happymonk-ai/enclosures/Project/Battery Pack and Draft files/Battery pack 2U Full Rack Enclosure/img-3.JPG

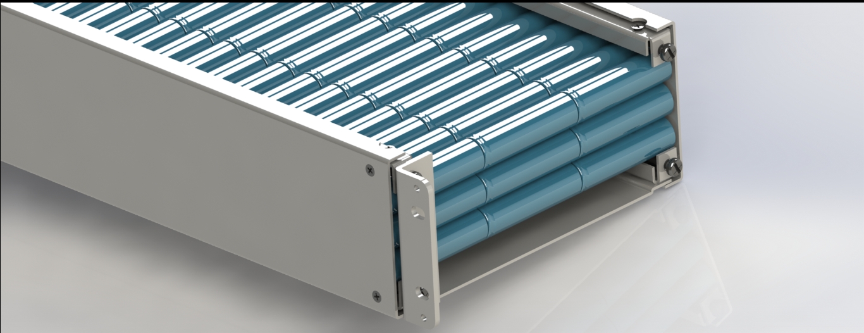
Project/Battery Pack and Draft files/Battery pack 2U Full Rack Enclosure/img-3.JPG
