happymonk-ai/enclosures/Project/New Main Module Enclosure/ethernet-switch-1.snapshot.3/Mercusys_MS105G.JPG

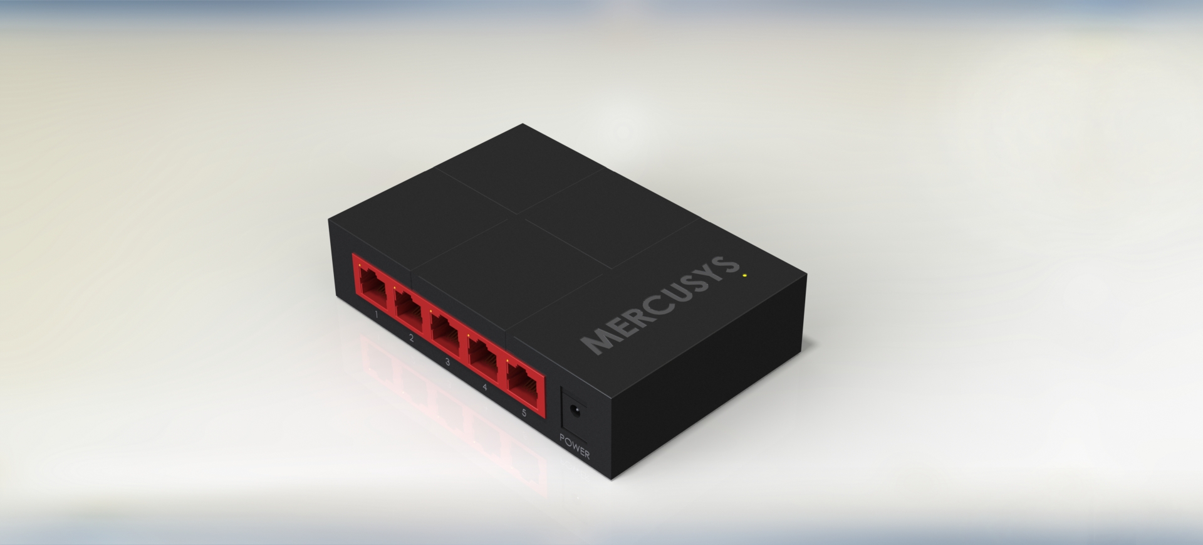
Project/New Main Module Enclosure/ethernet-switch-1.snapshot.3/Mercusys_MS105G.JPG
