happymonk-ai/enclosures/Project/Battery Pack and Draft files/Battery pack 1U Full Rack Enclosure/Batteries Placed horizontally in 1u .jpg

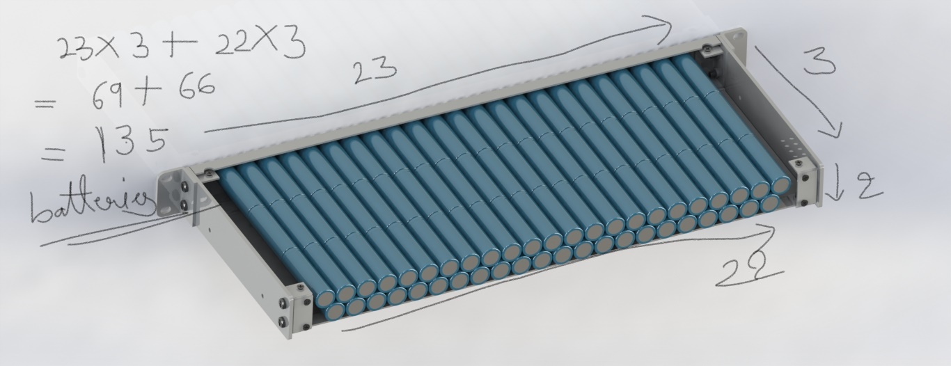
Project/Battery Pack and Draft files/Battery pack 1U Full Rack Enclosure/Batteries Placed horizontally in 1u .jpg
