happymonk-ai/enclosures/Project/Battery Pack and Draft files/Battery pack 1U Full Rack Enclosure/Battery placed perfectly.JPG

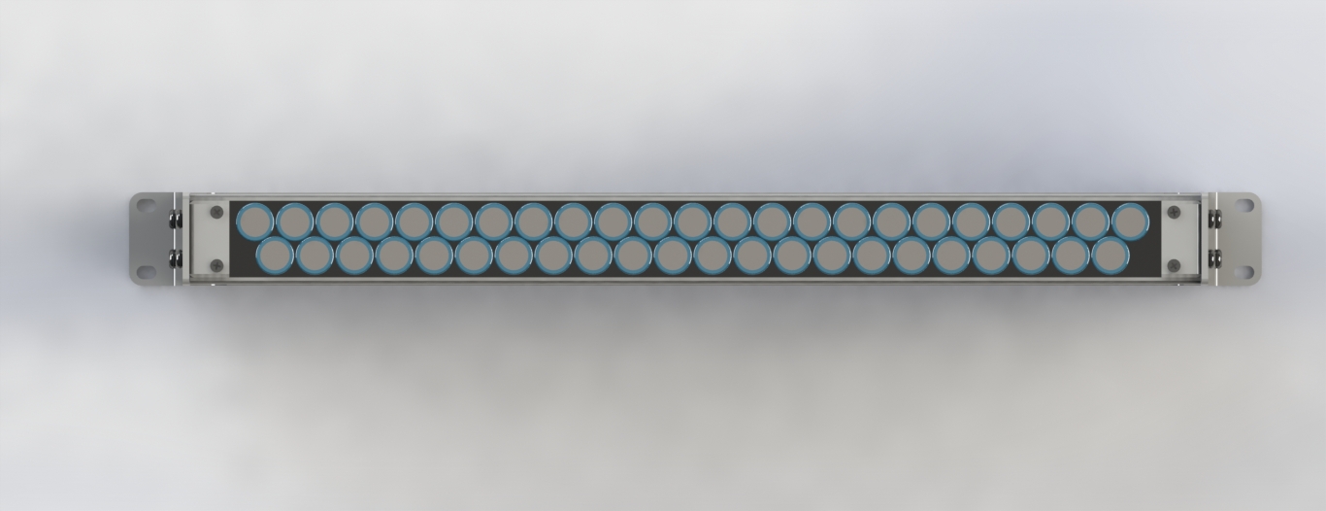
Project/Battery Pack and Draft files/Battery pack 1U Full Rack Enclosure/Battery placed perfectly.JPG
