happymonk-ai/enclosures/Project/Battery Pack and Draft files/Battery pack 1U Full Rack Enclosure/img - 1.JPG

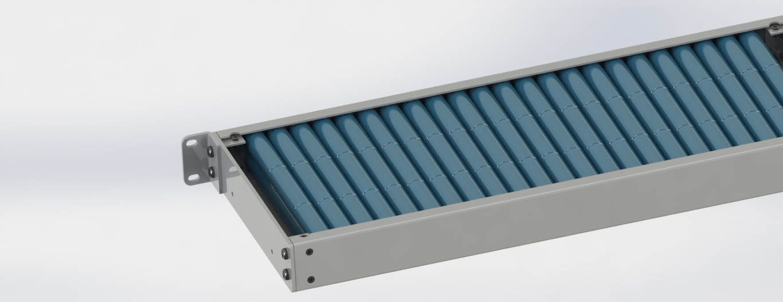
Project/Battery Pack and Draft files/Battery pack 1U Full Rack Enclosure/img - 1.JPG
