happymonk-ai/enclosures/Project/Battery Pack and Draft files/Battery pack 2U Full Rack Enclosure/batteries place vertically.JPG

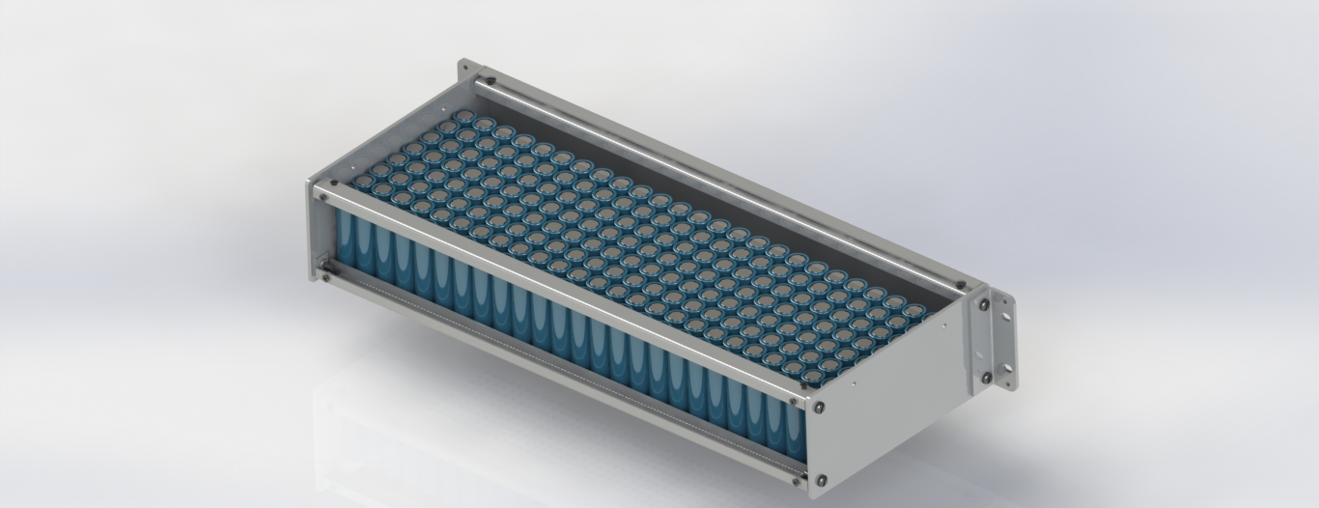
Project/Battery Pack and Draft files/Battery pack 2U Full Rack Enclosure/batteries place vertically.JPG
