happymonk-ai/enclosures/Project/Battery Pack and Draft files/Battery pack 2U Full Rack Enclosure/Batteries placed horizontal to the front plate.jpg

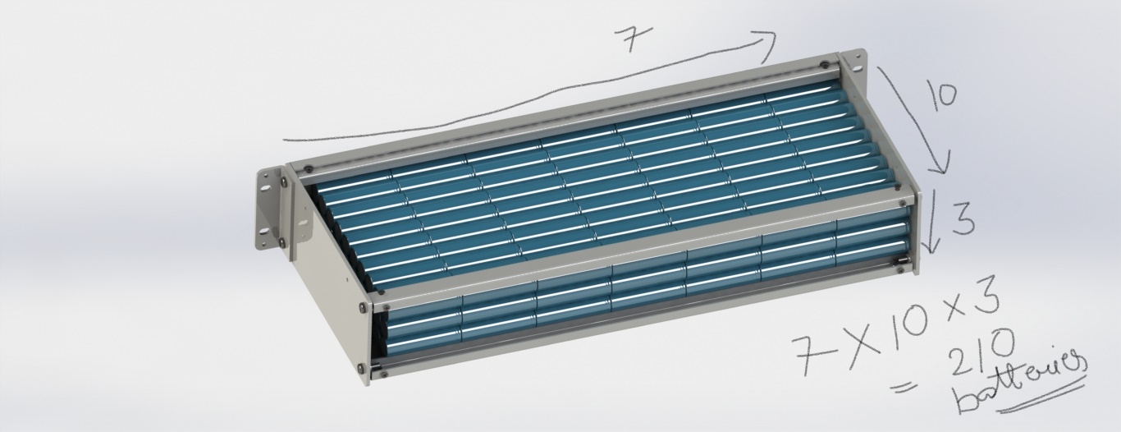
Project/Battery Pack and Draft files/Battery pack 2U Full Rack Enclosure/Batteries placed horizontal to the front plate.jpg
