happymonk-ai/enclosures/Project/Full Rack/8-port-rj45-socket-1.snapshot.2/RJ45 x 8.jpg

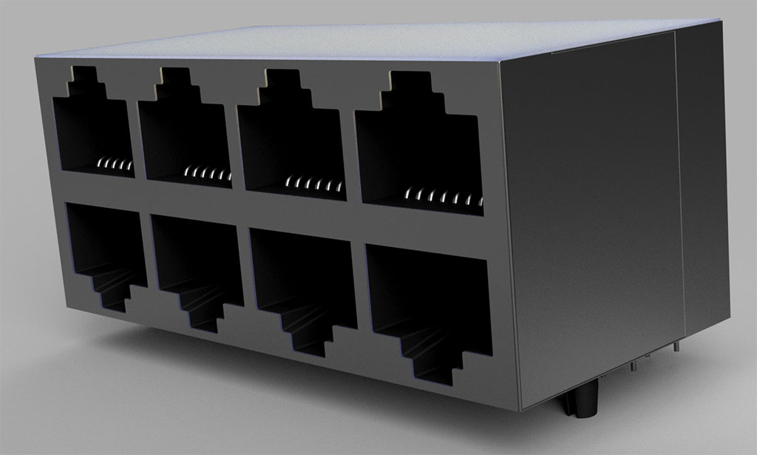
Project/Full Rack/8-port-rj45-socket-1.snapshot.2/RJ45 x 8.jpg
