happymonk-ai/enclosures/Project/New Main Module Enclosure/Ethernet cable - 1/909.png

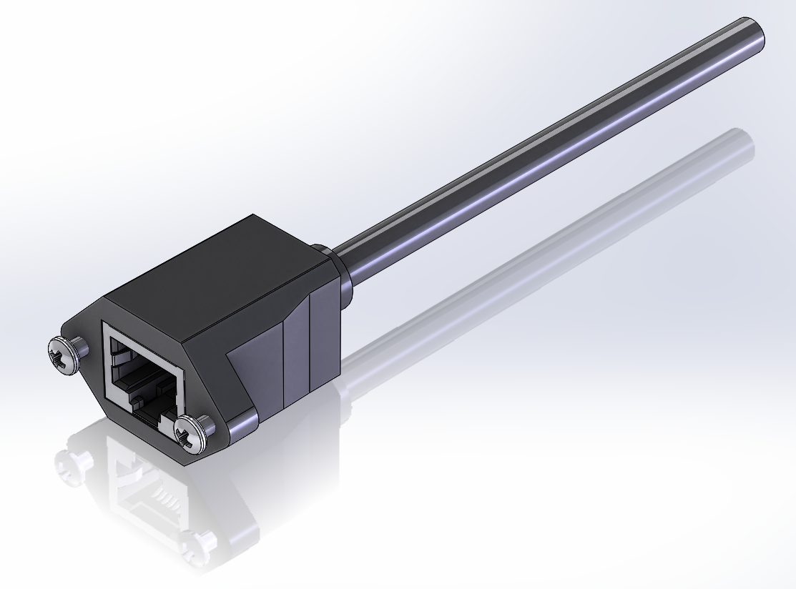
Project/New Main Module Enclosure/Ethernet cable - 1/909.png
