happymonk-ai/enclosures/Project/New Main Module Enclosure/Ethernet RJ45/img.JPG

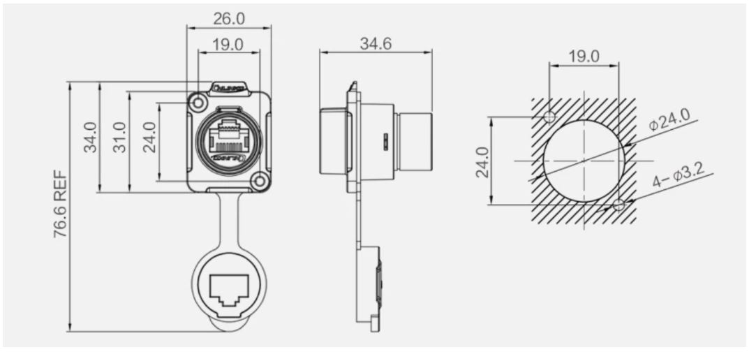
Project/New Main Module Enclosure/Ethernet RJ45/img.JPG
