happymonk-ai/enclosures/Project/New Main Module Enclosure/iec-screw-mount-plug-socket-male-1.snapshot.1/IEC Screw Mount Plug Socket Male/IEC Screw Mount Plug Socket Male-04.JPG

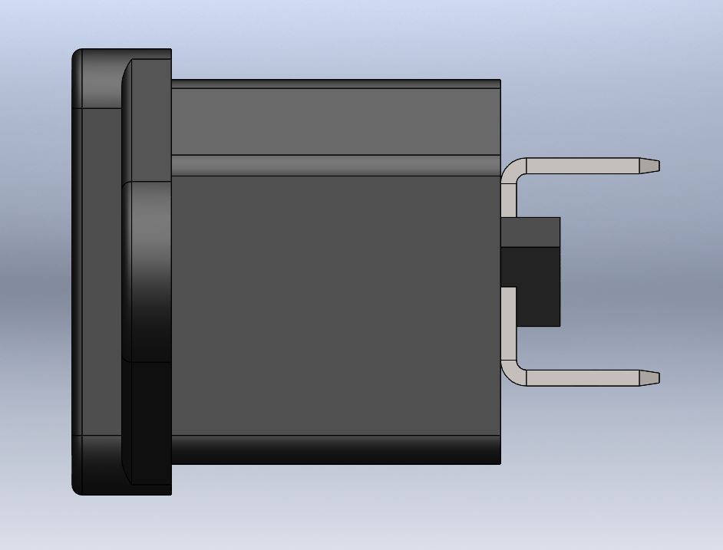
Project/New Main Module Enclosure/iec-screw-mount-plug-socket-male-1.snapshot.1/IEC Screw Mount Plug Socket Male/IEC Screw Mount Plug Socket Male-04.JPG
