happymonk-ai/enclosures/Project/New Main Module Enclosure/led-5mm-red-through-hole-1.snapshot.10/LED_5mm_red.png

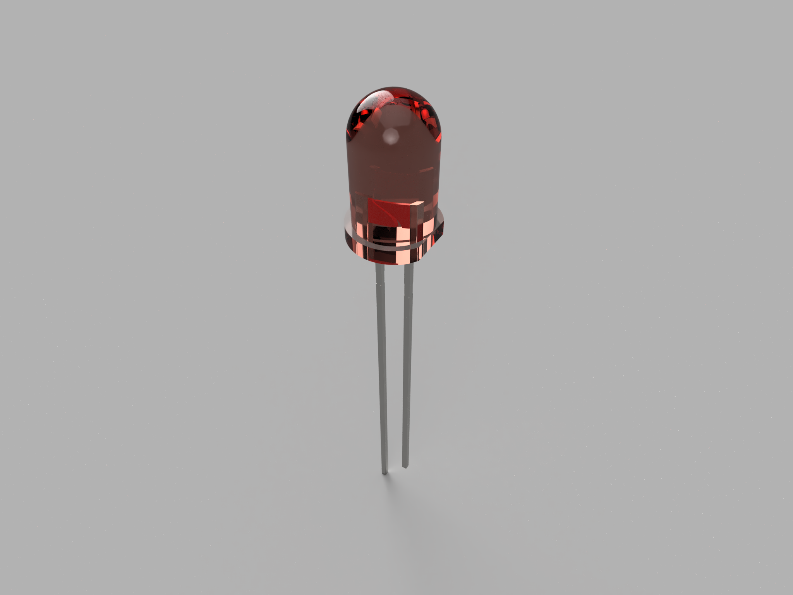
Project/New Main Module Enclosure/led-5mm-red-through-hole-1.snapshot.10/LED_5mm_red.png
