happymonk-ai/enclosures/Project/New Main Module Enclosure/power-connector-iec-c4-3-pins-1.snapshot.2/IEC-C4-3pins.JPG

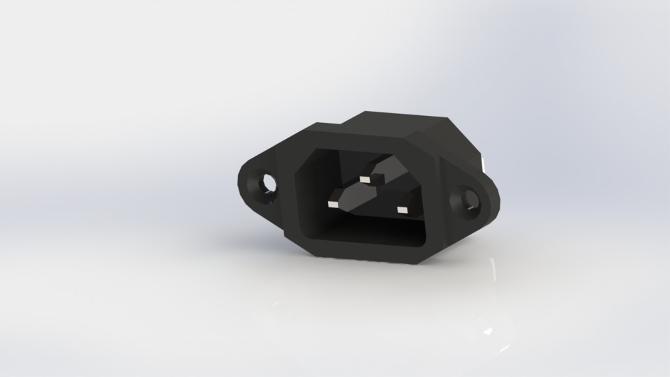
Project/New Main Module Enclosure/power-connector-iec-c4-3-pins-1.snapshot.2/IEC-C4-3pins.JPG
