happymonk-ai/enclosures/Project/New Main Module Enclosure/power-supply-24vdc-10a-1.snapshot.2/Power Supply 24VDC 10A v1.png

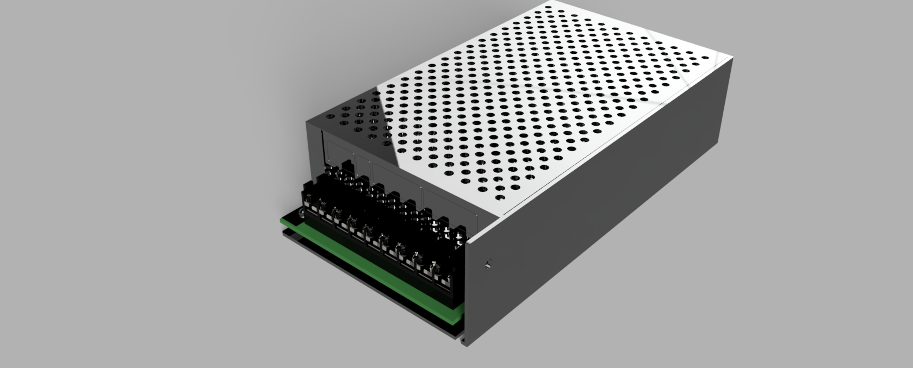
Project/New Main Module Enclosure/power-supply-24vdc-10a-1.snapshot.2/Power Supply 24VDC 10A v1.png
