happymonk-ai/enclosures/Project/New Main Module Enclosure/raspberry-pi-4-port-usb-hub-hat-1.snapshot.3/71MjlTHb0gL._SL1113_.jpg

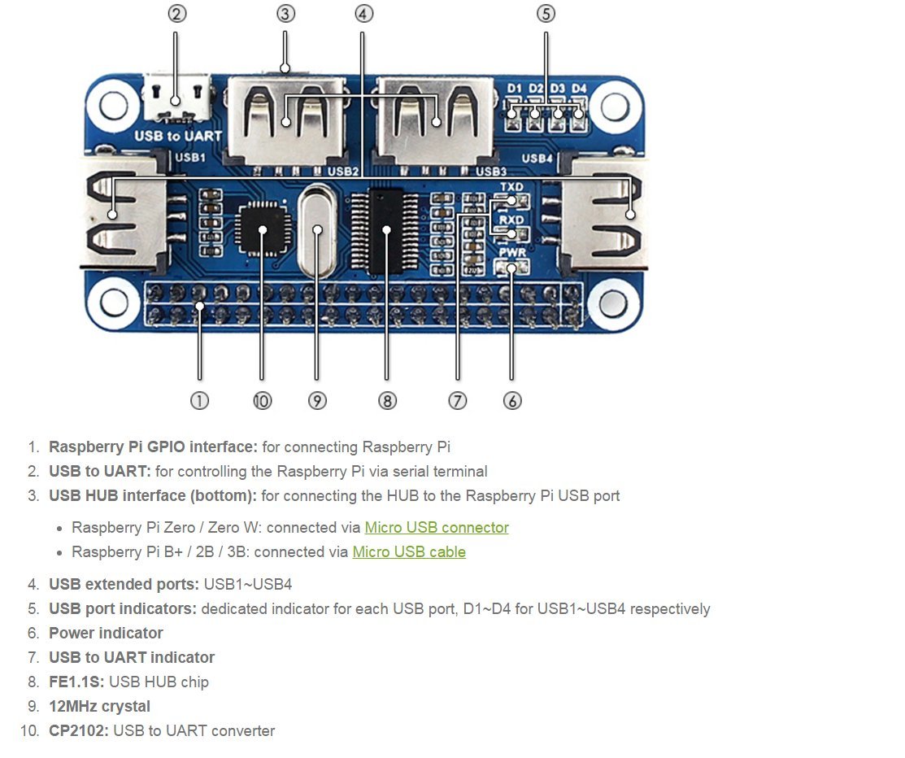
Project/New Main Module Enclosure/raspberry-pi-4-port-usb-hub-hat-1.snapshot.3/71MjlTHb0gL._SL1113_.jpg
