happymonk-ai/enclosures/Project/New Main Module Enclosure/raspberry-pi-4-port-usb-hub-hat-1.snapshot.3/PCB 65x30x1.6.jpg

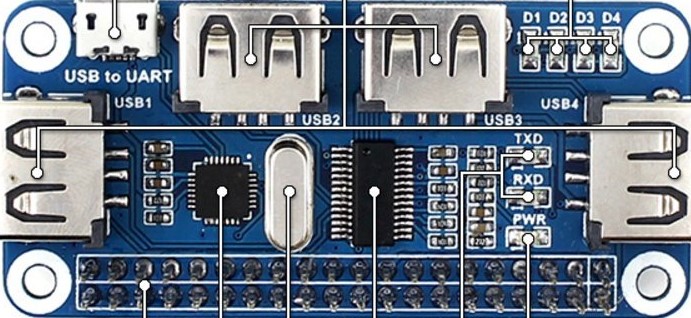
Project/New Main Module Enclosure/raspberry-pi-4-port-usb-hub-hat-1.snapshot.3/PCB 65x30x1.6.jpg
