happymonk-ai/enclosures/Project/New Main Module Enclosure/raspberry-pi-4-port-usb-hub-hat-1.snapshot.3/Raspberry pi 4 Port USB HUB HAT - 1.JPG

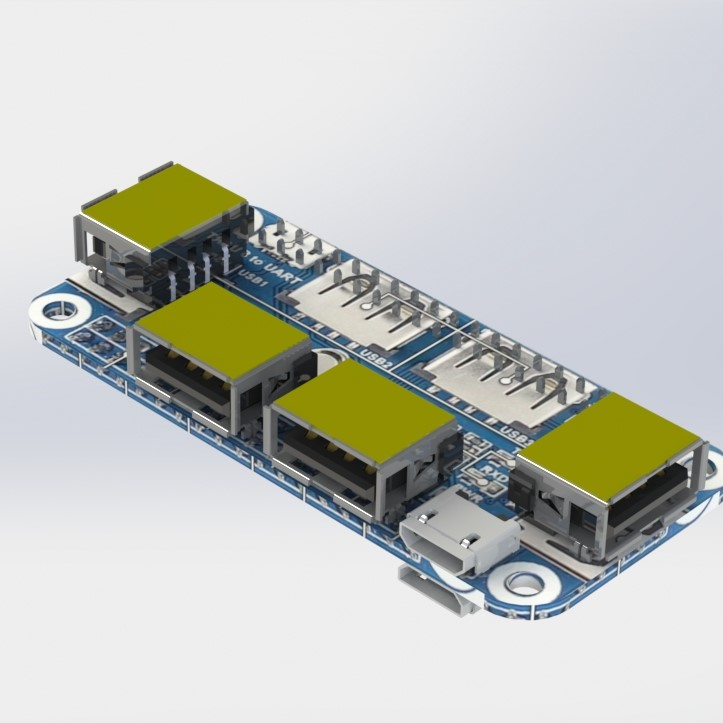
Project/New Main Module Enclosure/raspberry-pi-4-port-usb-hub-hat-1.snapshot.3/Raspberry pi 4 Port USB HUB HAT - 1.JPG
