happymonk-ai/enclosures/Project/New Main Module Enclosure/USB RJ45/img - 1.JPG

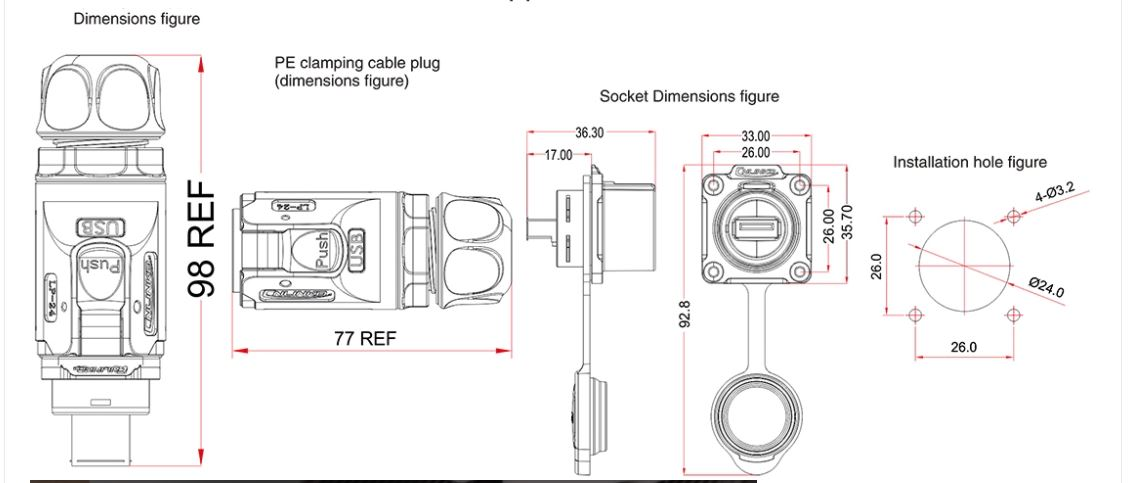
Project/New Main Module Enclosure/USB RJ45/img - 1.JPG
