happymonk-ai/enclosures/Project/Battery Pack and Draft files/Project/Full rack 2U Enclosure Project.SLDASM

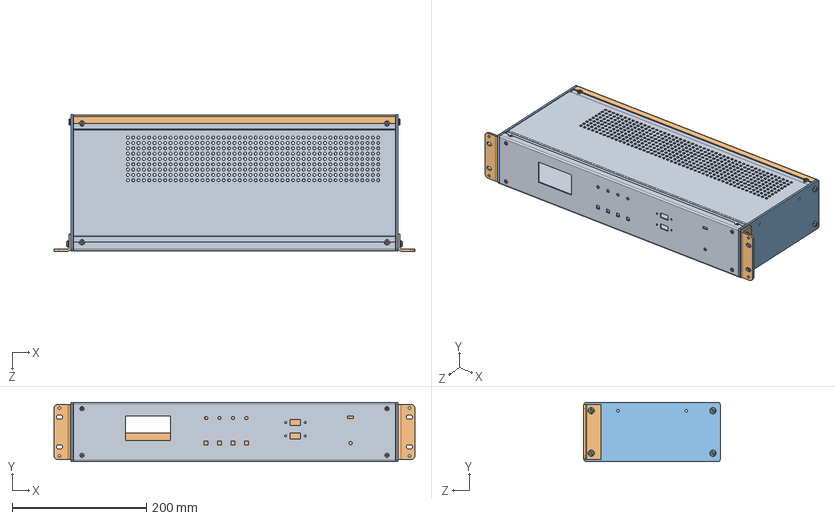
[picture p31: CAD file, 2021-10-08]
Project/Battery Pack and Draft files/Project/Full rack 2U Enclosure Project.SLDASM
537.9 x 88.4 x 203.4 mm
COM53877-2 x 2
COM53880 x 2
COM53875-2 x 2
SCS19498 x 8
SCS19535 x 16
NTS16752 x 16
COM53874-2 x 4
NTS16847 x 8
Front Plate - 1
Front plate - 2
