happymonk-ai/enclosures/Project/Half Rack/Antenna/NRF24L01L + Antenna 2.4 GHz/Antenna assy.SLDASM

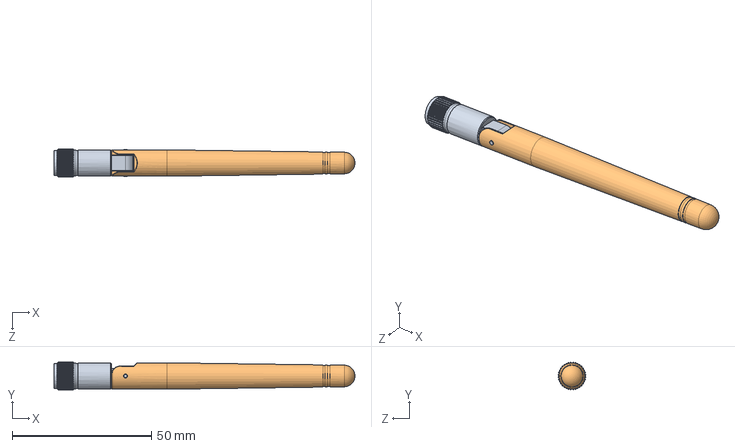
[picture p32: CAD file, 2021-09-29]
Project/Half Rack/Antenna/NRF24L01L + Antenna 2.4 GHz/Antenna assy.SLDASM
108.2 x 9.98 x 9.98 mm
Antenna base
Antenna top
