happymonk-ai/enclosures/Project/New Main Module Enclosure/Box for Main Module.SLDPRT

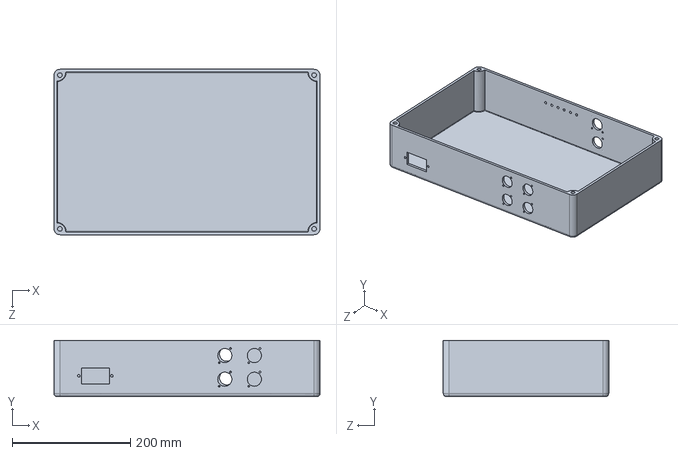
[picture p33: CAD file, 2021-11-02]
Project/New Main Module Enclosure/Box for Main Module.SLDPRT
450.0 x 95.0 x 280.0 mm
