happymonk-ai/enclosures/Project/New Main Module Enclosure/HDMI RJ45/Connector.sldasm

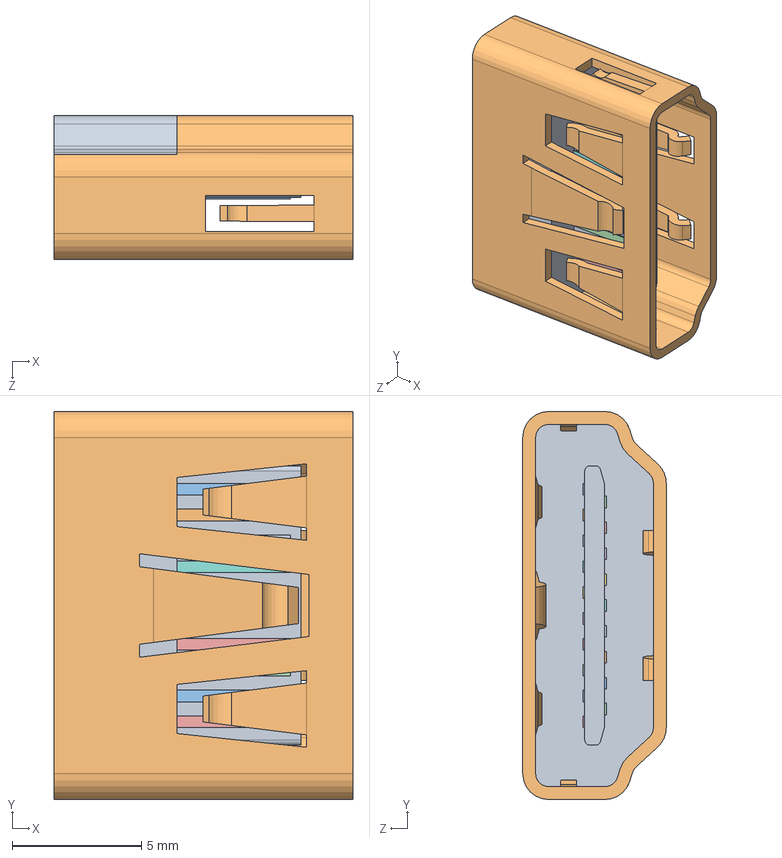
[picture p34: CAD file, 2021-11-02]
Project/New Main Module Enclosure/HDMI RJ45/Connector.sldasm
11.6 x 15.0 x 5.55 mm
Mold
Pins_18
Pins_10
Pins_7
Pins_12
Pins_3
Pins_19
Pins_4
Pins_17
Pins_5
Pins_2
Pins_16
Pins_11
Pins_6
Pins_14
Pins_9
Pins_13
Pins
Pins_8
Pins_15
