happymonk-ai/enclosures/Project/New Main Module Enclosure/led-5mm-red-through-hole-1.snapshot.10/LED, 5mm, green v4.SLDASM

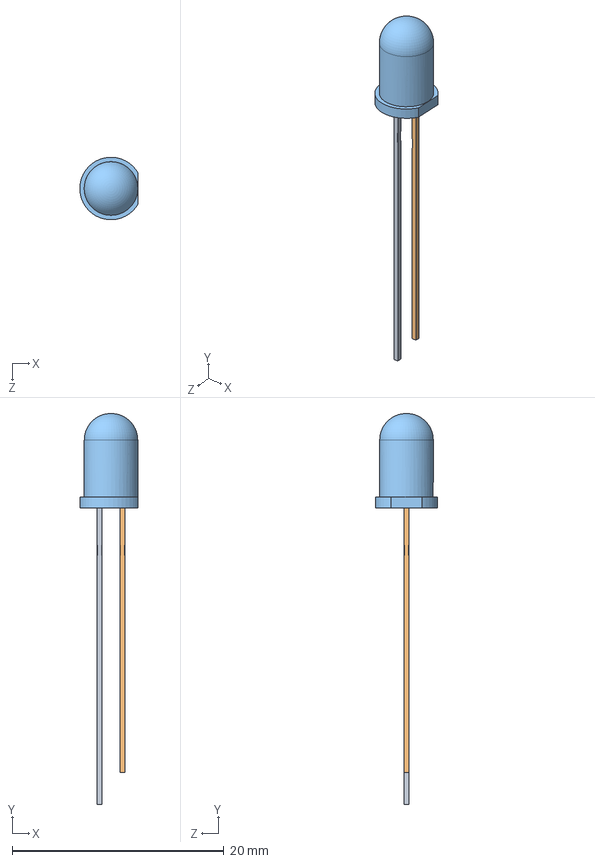
[picture p35: CAD file, 2021-10-27]
Project/New Main Module Enclosure/led-5mm-red-through-hole-1.snapshot.10/LED, 5mm, green v4.SLDASM
5.51 x 36.9 x 5.89 mm
Legs
Legs_2
PlasticHousing
