happymonk-ai/enclosures/Project/Battery Pack and Draft files/Battery pack 2U Full Rack Enclosure/Li ion Battery/li-ion-battery-18650-18500-18350-1.snapshot.2/Lithium ion 3.7V 18650 battery.SLDASM

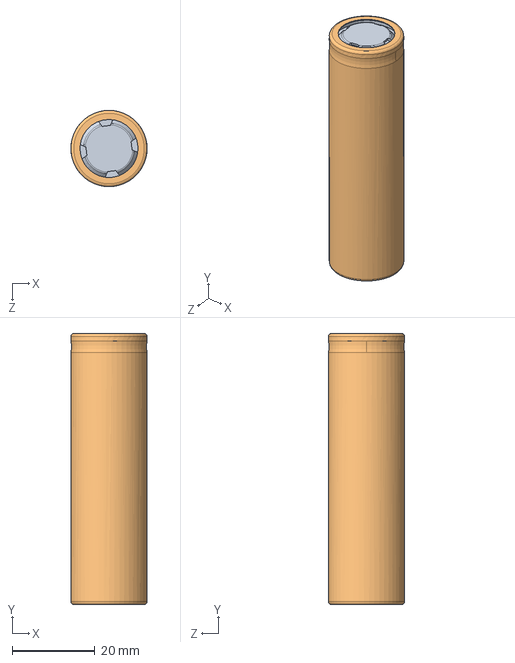
[picture p37: CAD file, 2021-10-08]
Project/Battery Pack and Draft files/Battery pack 2U Full Rack Enclosure/Li ion Battery/li-ion-battery-18650-18500-18350-1.snapshot.2/Lithium ion 3.7V 18650 battery.SLDASM
18.4 x 65.4 x 18.4 mm
18650 Низкий анод_2
18650 Низкий анод
