happymonk-ai/enclosures/Project/Full Rack/2U Full Rack Enclosure/Full Rack Enclosure.SLDASM

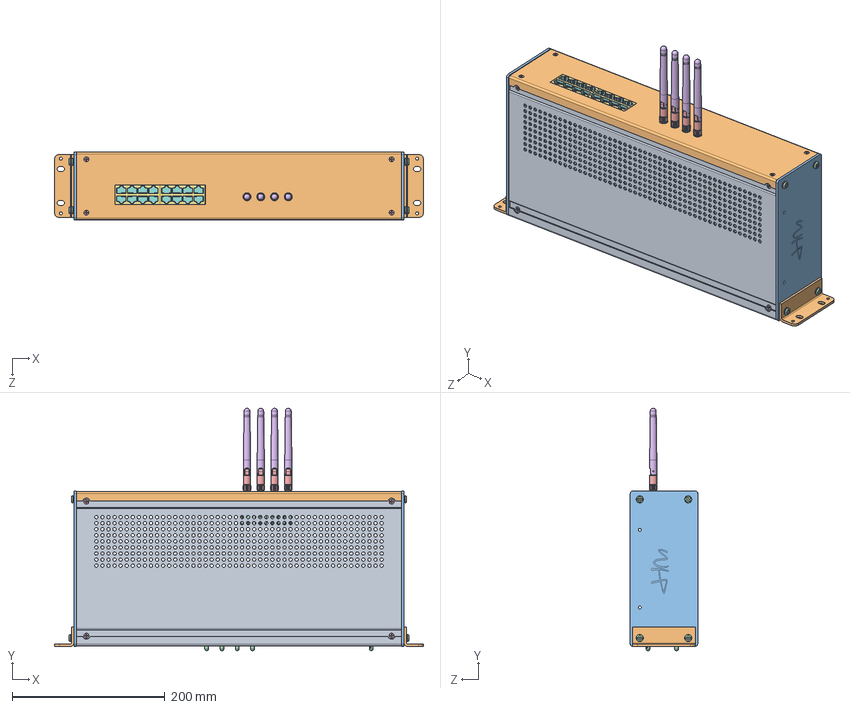
[picture p38: CAD file, 2021-10-08]
Project/Full Rack/2U Full Rack Enclosure/Full Rack Enclosure.SLDASM
482.6 x 317.2 x 88.5 mm
COM53877-2 x 2
COM53880 x 2
COM53875-2 x 2
SCS19498 x 8
SCS19535 x 16
NTS16752 x 16
COM53874-2 x 4
NTS16847 x 8
Front Plate - 1
Front plate - 2
RJ45 x 16_4 x 2
RJ45 x 16_10 x 2
RJ45 x 16_21 x 2
RJ45 x 16_23 x 2
RJ45 x 16_14 x 2
RJ45 x 16_25 x 2
RJ45 x 16_6 x 2
RJ45 x 16_17 x 2
RJ45 x 16_16 x 2
RJ45 x 16_32 x 2
RJ45 x 16_37 x 2
RJ45 x 16_8 x 2
RJ45 x 16_31 x 2
RJ45 x 16_2 x 2
RJ45 x 16_36 x 2
RJ45 x 16_34 x 2
RJ45 x 16_27 x 2
RJ45 x 16_19 x 2
RJ45 x 16_29 x 2
RJ45 x 16_12 x 2
RJ45 x 16_9 x 2
RJ45 x 16_22 x 2
RJ45 x 16_24 x 2
RJ45 x 16_28 x 2
RJ45 x 16_13 x 2
RJ45 x 16_3 x 2
RJ45 x 16_35 x 2
RJ45 x 16_20 x 2
RJ45 x 16_5 x 2
RJ45 x 16_15 x 2
RJ45 x 16 x 2
RJ45 x 16_18 x 2
RJ45 x 16_30 x 2
RJ45 x 16_33 x 2
RJ45 x 16_26 x 2
RJ45 x 16_11 x 2
RJ45 x 16_7 x 2
Socket_69 x 2
Socket_62 x 2
Socket_86 x 2
Socket_52 x 2
Socket_19 x 2
Socket_34 x 2
Socket_8 x 2
Socket_97 x 2
Socket_16 x 2
Socket_25 x 2
Socket_80 x 2
Socket_46 x 2
Socket_43 x 2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
