happymonk-ai/enclosures/Project/New Main Module Enclosure/HDMI RJ45/HDMI Female Connector Assembly.SLDASM

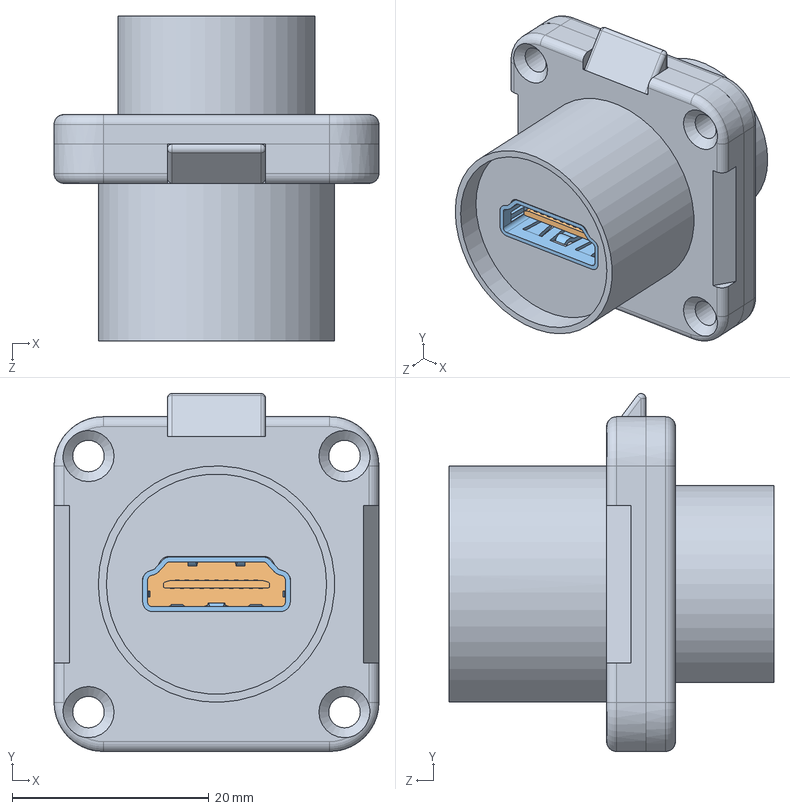
[picture p39: CAD file, 2021-11-02]
Project/New Main Module Enclosure/HDMI RJ45/HDMI Female Connector Assembly.SLDASM
33.0 x 36.4 x 33.0 mm
HDMI Female Female Connector
Mold x 2
Pins_18 x 2
Pins_10 x 2
Pins_7 x 2
Pins_12 x 2
Pins_3 x 2
Pins_19 x 2
Pins_4 x 2
Pins_17 x 2
Pins_5 x 2
Pins_2 x 2
Pins_16 x 2
Pins_11 x 2
Pins_6 x 2
Pins_14 x 2
Pins_9 x 2
Pins_13 x 2
Pins x 2
Pins_8 x 2
Pins_15 x 2
