happymonk-ai/enclosures/Project/New Main Module Enclosure/USB RJ45/USB Assembly.SLDASM

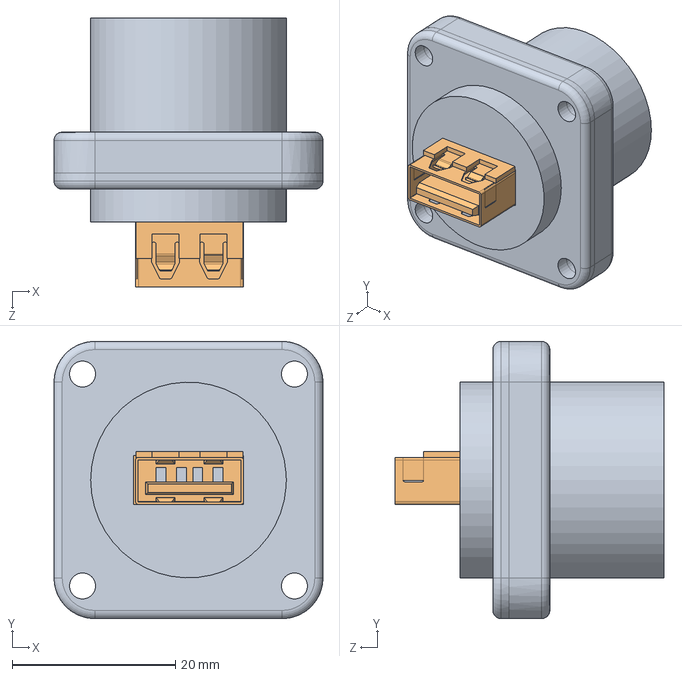
[picture p40: CAD file, 2021-11-02]
Project/New Main Module Enclosure/USB RJ45/USB Assembly.SLDASM
33.0 x 34.0 x 33.0 mm
USB Femal to Female Connector
My USB drive x 2
