happymonk-ai/enclosures/Project/Battery Pack and Draft files/Battery pack 2U Full Rack Enclosure/Battery Pack Enclosure.SLDASM

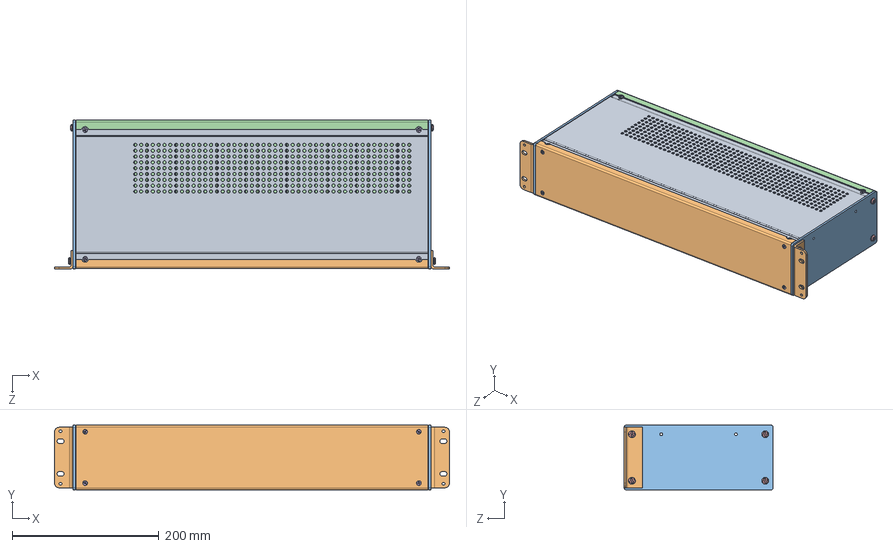
[picture p41: CAD file, 2021-10-13]
Project/Battery Pack and Draft files/Battery pack 2U Full Rack Enclosure/Battery Pack Enclosure.SLDASM
537.9 x 88.4 x 203.4 mm
COM53877-2 x 2
COM53880 x 2
COM53875-2 x 2
SCS19498 x 8
SCS19535 x 16
NTS16752 x 16
COM53874-2 x 4
NTS16847 x 8
front enclose part
18650 Низкий анод_2 x 225
18650 Низкий анод x 225
