happymonk-ai/enclosures/Project/Battery Pack and Draft files/Project/Full rack 2U Enclosure Project - spare.SLDASM

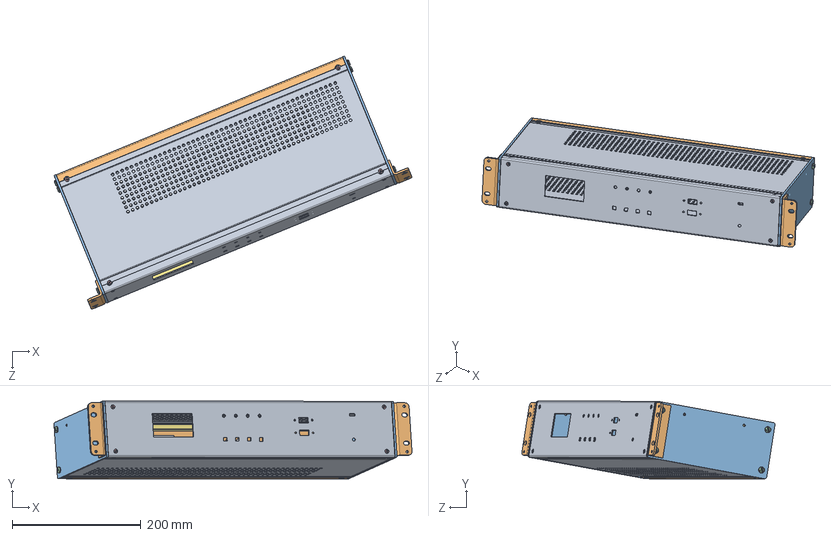
[picture p42: CAD file, 2021-10-08]
Project/Battery Pack and Draft files/Project/Full rack 2U Enclosure Project - spare.SLDASM
555.1 x 120.5 x 392.4 mm
COM53877-2 x 2
COM53880 x 2
COM53875-2 x 2
SCS19498 x 8
SCS19535 x 16
NTS16752 x 16
COM53874-2 x 4
NTS16847 x 8
Front Plate - 1
Front plate - 2
