happymonk-ai/enclosures/Project/Half Rack/Antenna/NRF24L01L + Antenna 2.4 GHz/NRF24L01L+Antenna.SLDASM

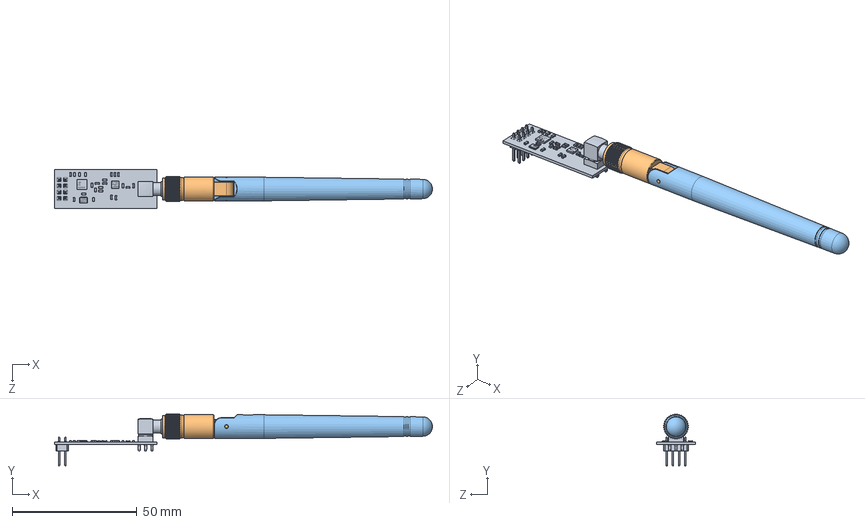
[picture p43: CAD file, 2021-09-29]
Project/Half Rack/Antenna/NRF24L01L + Antenna 2.4 GHz/NRF24L01L+Antenna.SLDASM
151.4 x 20.7 x 15.5 mm
NRF24L01L
Antenna base
Antenna top
