happymonk-ai/enclosures/Project/New Main Module Enclosure/Ethernet RJ45/Ethernet RJ45 Assembly.SLDASM

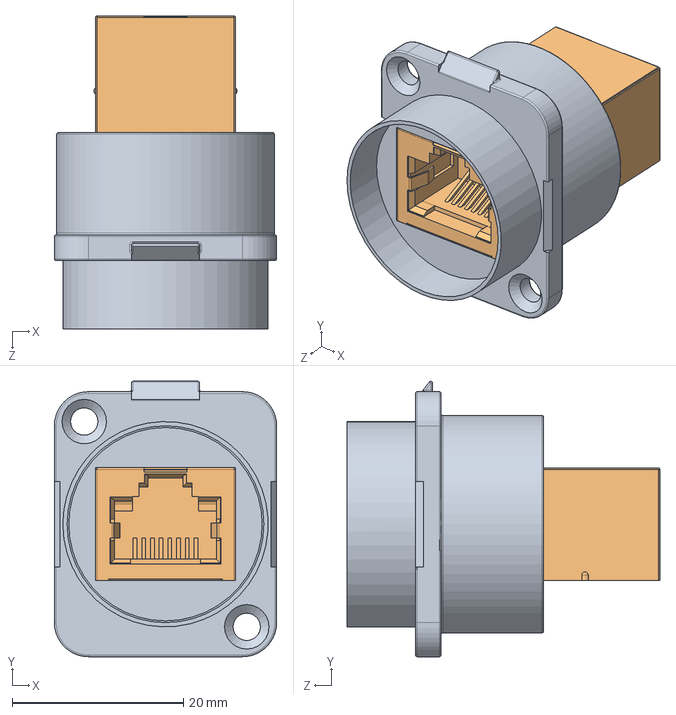
[picture p44: CAD file, 2021-11-02]
Project/New Main Module Enclosure/Ethernet RJ45/Ethernet RJ45 Assembly.SLDASM
26.0 x 32.2 x 36.6 mm
Ethernet Female to Female Input RJ45
Just Ethernet RJ-45 connector x 2
