happymonk-ai/enclosures/Project/New Main Module Enclosure/raspberry-pi-4-port-usb-hub-hat-1.snapshot.3/Raspberry pi 4 Port USB HUB HAT.SLDASM

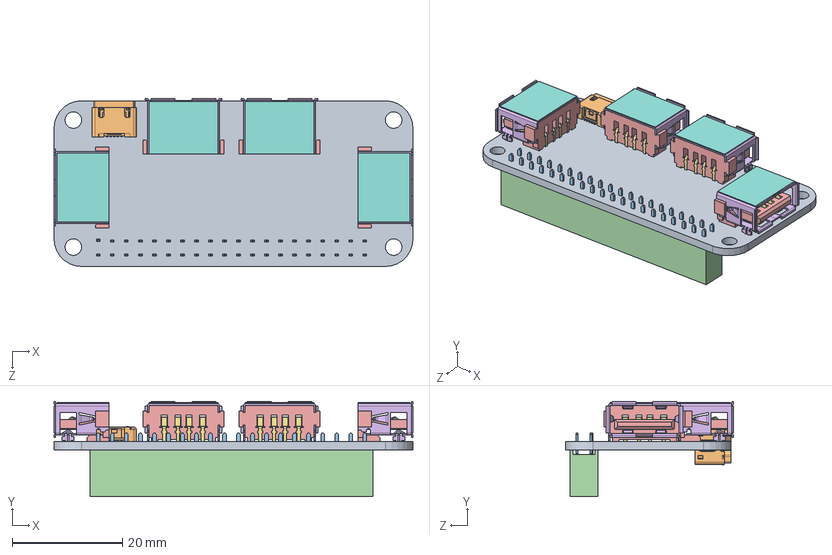
[picture p45: CAD file, 2021-10-27]
Project/New Main Module Enclosure/raspberry-pi-4-port-usb-hub-hat-1.snapshot.3/Raspberry pi 4 Port USB HUB HAT.SLDASM
65.0 x 17.2 x 30.4 mm
PCB 65x30x1.6
629105150521 (rev1) x 2
6130xx21821_PIN x 40
614104150121_Pin x 16
Mylar x 4
