happymonk-ai/enclosures/Project/New Main Module Enclosure/usb-a-female-short-body-1.snapshot.1/USB Female Part.SLDASM

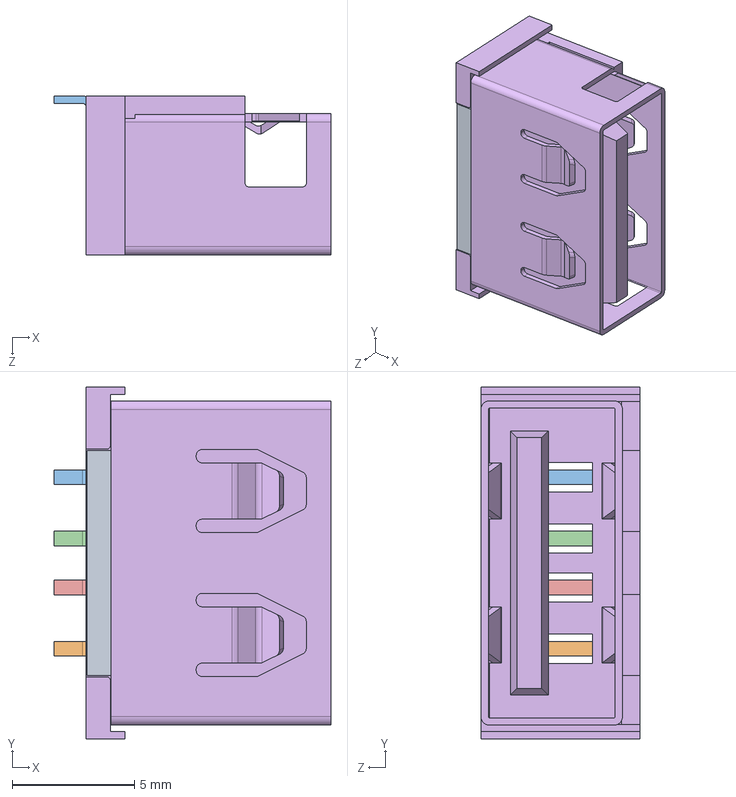
[picture p46: CAD file, 2021-11-02]
Project/New Main Module Enclosure/usb-a-female-short-body-1.snapshot.1/USB Female Part.SLDASM
11.3 x 14.4 x 6.50 mm
USB-A母座短#1_5
USB-A母座短#1_6
USB-A母座短#1_3
USB-A母座短#1_2
USB-A母座短#1
USB-A母座短#1_4
