happymonk-ai/enclosures/Project/Battery Pack and Draft files/Project/2U Half rack/Half rack 2U Enclosure Project.SLDASM

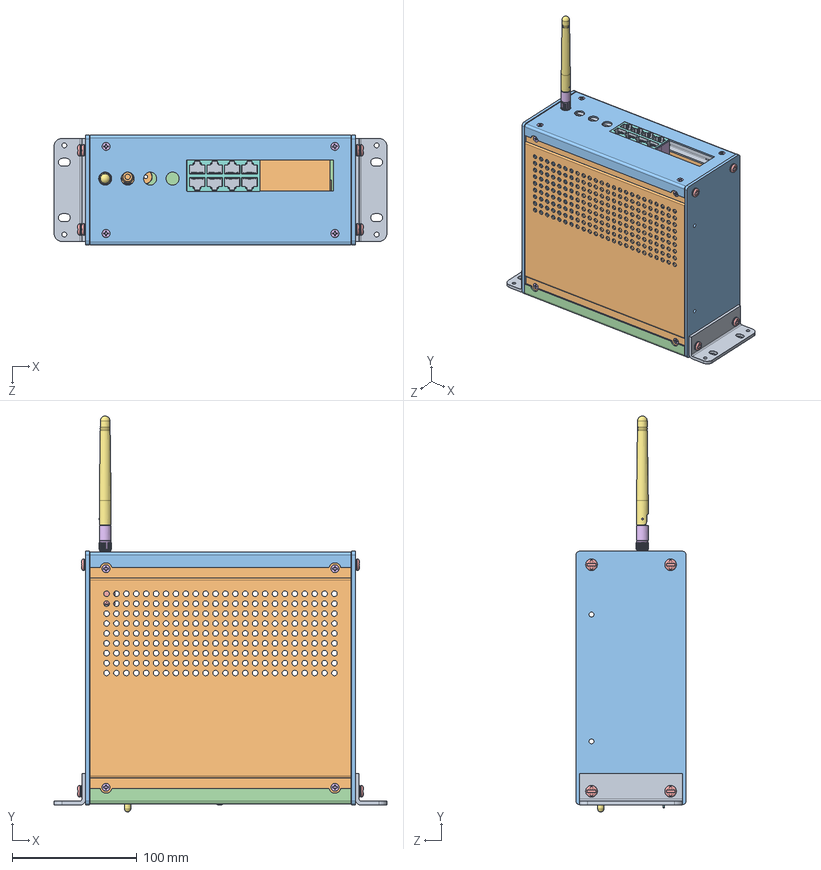
[picture p47: CAD file, 2021-10-08]
Project/Battery Pack and Draft files/Project/2U Half rack/Half rack 2U Enclosure Project.SLDASM
266.7 x 317.2 x 88.4 mm
COM53880 x 2
COM53877-1 x 2
COM53875-2 x 2
COM53878-2
SCS19498 x 8
SCS19535 x 16
NTS16752 x 12
NTS16847 x 12
COM53874-1 x 4
COM53878-3
