happymonk-ai/enclosures/Project/New Main Module Enclosure/Main Module 2U Rack Enclosure/Main Module 2U Full Rack/Main Module Rack Enclosure.SLDASM

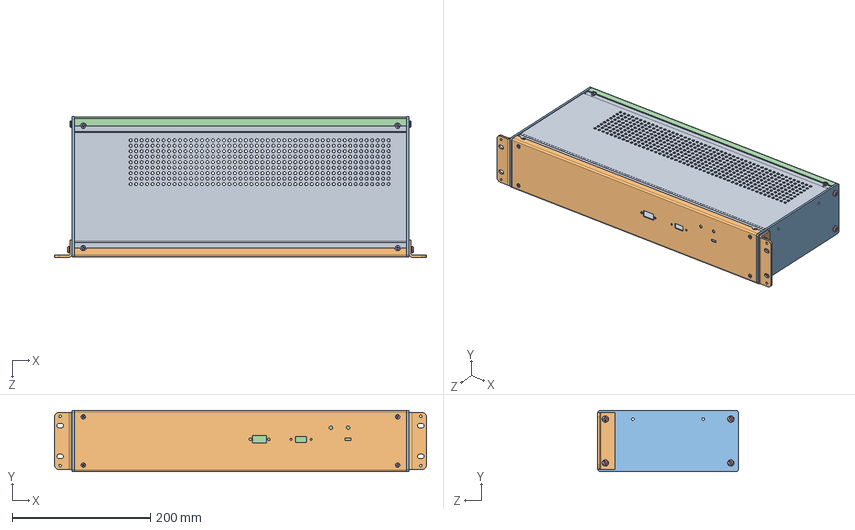
[picture p48: CAD file, 2021-10-27]
Project/New Main Module Enclosure/Main Module 2U Rack Enclosure/Main Module 2U Full Rack/Main Module Rack Enclosure.SLDASM
537.9 x 88.4 x 203.4 mm
COM53877-2
COM53880 x 2
COM53875-2 x 2
rear enclose part
SCS19498 x 8
SCS19535 x 16
NTS16752 x 16
COM53874-2 x 4
NTS16847 x 8
front enclose part
