happymonk-ai/enclosures/Project/Battery Pack and Draft files/1U Full rack/1U Full Rack Enclosure.SLDASM

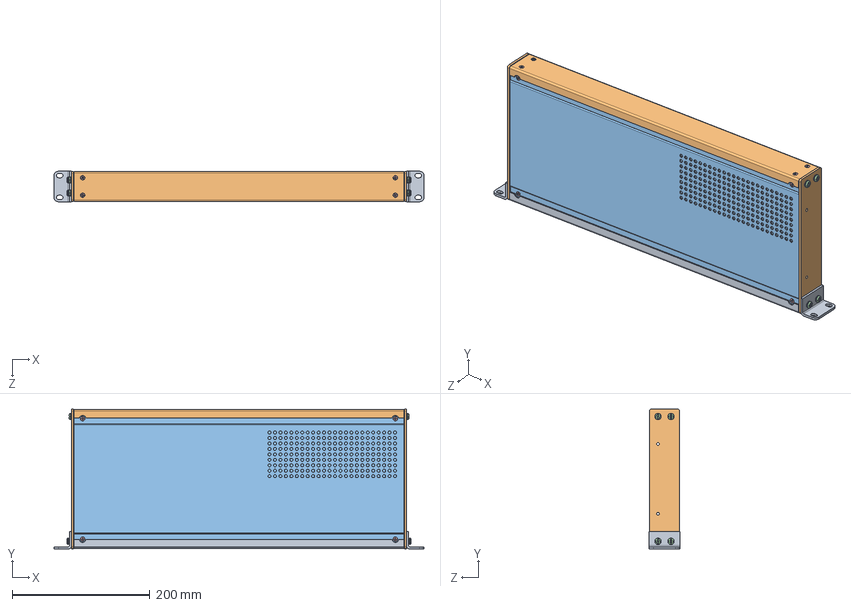
[picture p49: CAD file, 2021-10-08]
Project/Battery Pack and Draft files/1U Full rack/1U Full Rack Enclosure.SLDASM
538.0 x 203.4 x 44.5 mm
COM53879 x 2
COM53875-1 x 2
COM53877-1 x 2
SCS19498 x 8
SCS19535 x 16
COM54125 x 4
NTS16847 x 8
NTS16752 x 16
Front Part
Rear Part
