happymonk-ai/enclosures/Project/Battery Pack and Draft files/2U Full rack/2U Full rack Enclosure.SLDASM

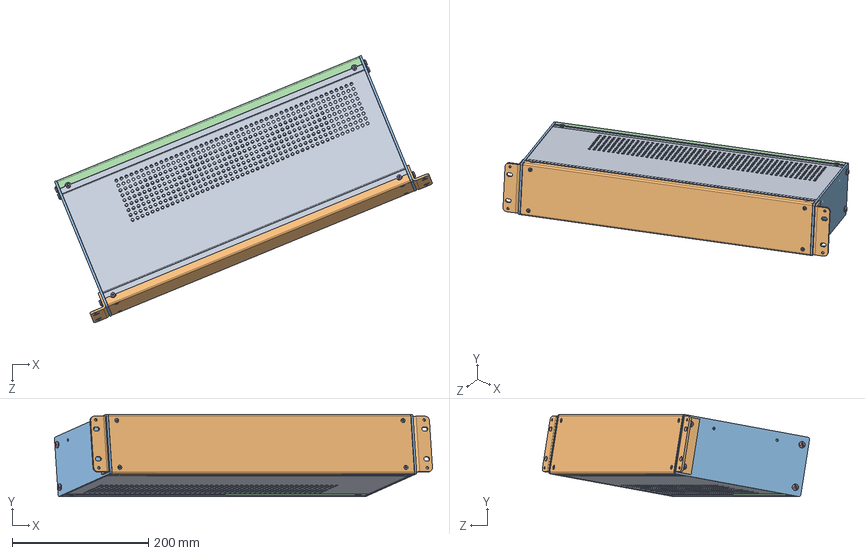
[picture p50: CAD file, 2021-10-08]
Project/Battery Pack and Draft files/2U Full rack/2U Full rack Enclosure.SLDASM
555.1 x 120.5 x 392.4 mm
COM53877-2 x 2
COM53880 x 2
COM53875-2 x 2
rear enclose part
SCS19498 x 8
SCS19535 x 16
NTS16752 x 16
COM53874-2 x 4
NTS16847 x 8
front enclose part
