happymonk-ai/enclosures/Project/Half Rack/8-port-rj45-socket-1.snapshot.2/RJ45 x 8.SLDASM

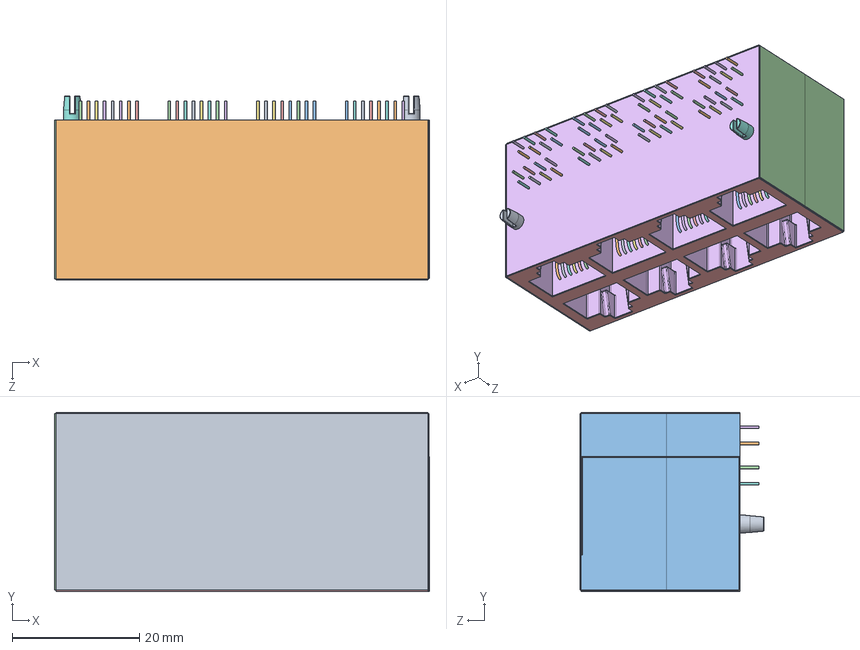
[picture p51: CAD file, 2021-09-29]
Project/Half Rack/8-port-rj45-socket-1.snapshot.2/RJ45 x 8.SLDASM
59.0 x 28.2 x 29.0 mm
RJ45 x 16_4
RJ45 x 16_10
RJ45 x 16_21
RJ45 x 16_23
RJ45 x 16_14
RJ45 x 16_25
RJ45 x 16_6
RJ45 x 16_17
RJ45 x 16_16
RJ45 x 16_32
RJ45 x 16_37
RJ45 x 16_8
RJ45 x 16_31
RJ45 x 16_2
RJ45 x 16_36
RJ45 x 16_34
RJ45 x 16_27
RJ45 x 16_19
RJ45 x 16_29
RJ45 x 16_12
RJ45 x 16_9
RJ45 x 16_22
RJ45 x 16_24
RJ45 x 16_28
RJ45 x 16_13
RJ45 x 16_3
RJ45 x 16_35
RJ45 x 16_20
RJ45 x 16_5
RJ45 x 16_15
RJ45 x 16
RJ45 x 16_18
RJ45 x 16_30
RJ45 x 16_33
RJ45 x 16_26
RJ45 x 16_11
RJ45 x 16_7
Socket_69
Socket_62
Socket_86
Socket_52
Socket_19
Socket_34
Socket_8
Socket_97
Socket_16
Socket_25
Socket_80
Socket_46
Socket_43
Socket_89
Socket_4
Socket_72
Socket_55
Socket_57
Socket_38
Socket_42
Socket_66
Socket_13
Socket_31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
