happymonk-ai/enclosures/Project/New Main Module Enclosure/Jetson_Nano_2GB_DevKit_P3541_3D_STEP_Model_nv/065-0743-000_1.sldasm

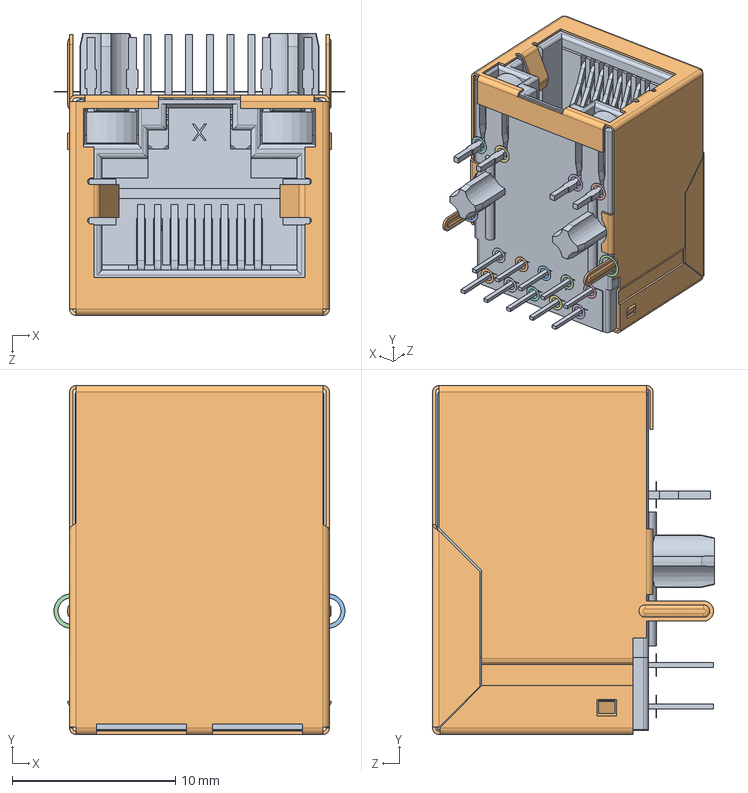
[picture p52: CAD file, 2021-11-02]
Project/New Main Module Enclosure/Jetson_Nano_2GB_DevKit_P3541_3D_STEP_Model_nv/065-0743-000_1.sldasm
17.8 x 21.4 x 17.2 mm
