happymonk-ai/enclosures/Project/New Main Module Enclosure/Jetson_Nano_2GB_DevKit_P3541_3D_STEP_Model_nv/600-13542-BASE-A02_ASM.sldasm

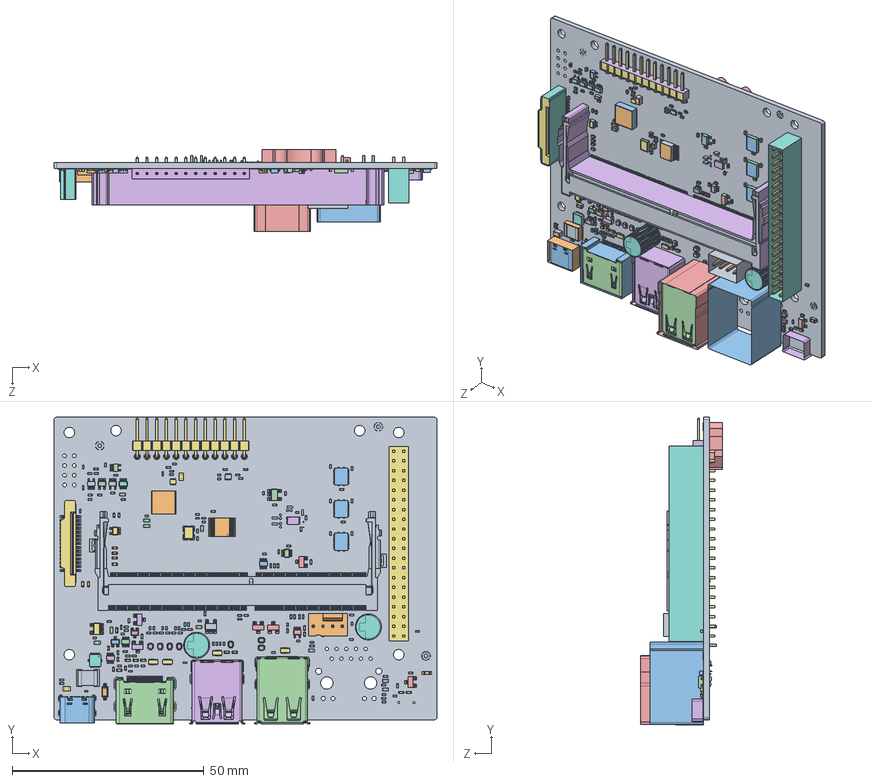
[picture p54: CAD file, 2021-11-02]
Project/New Main Module Enclosure/Jetson_Nano_2GB_DevKit_P3541_3D_STEP_Model_nv/600-13542-BASE-A02_ASM.sldasm
100.0 x 80.3 x 21.5 mm
600-13542-BASE-A02
LOGO_SILK_180_I560
LOGO_SILK_POSTAL_ADDRESS
LS_ICES_I0925X0040_CLASS_B
LOGO_SILK_P3542_2
LOGO_SILK_P3542_3
LOGO_SILK_P3542_9
LOGO_SILK_P3542
LOGO_SILK_P3542_6
LOGO_SILK_P3542_8
LOGO_SILK_P3542_7
LOGO_SILK_P3542_4
LOGO_SILK_P3542_5
LOGO_SILK_ROHS_I0300X0153_10
LOGO_SILK_ROHS_I0300X0153_8
LOGO_SILK_ROHS_I0300X0153_6
LOGO_SILK_ROHS_I0300X0153_9
LOGO_SILK_ROHS_I0300X0153_4
LOGO_SILK_ROHS_I0300X0153_2
LOGO_SILK_ROHS_I0300X0153_13
LOGO_SILK_ROHS_I0300X0153_3
LOGO_SILK_ROHS_I0300X0153_11
LOGO_SILK_ROHS_I0300X0153
LOGO_SILK_ROHS_I0300X0153_14
LOGO_SILK_ROHS_I0300X0153_12
LOGO_SILK_ROHS_I0300X0153_5
LOGO_SILK_ROHS_I0300X0153_7
LOGO_SILK_NVIDIA_I0400X0240_8
LOGO_SILK_NVIDIA_I0400X0240_10
LOGO_SILK_NVIDIA_I0400X0240_3
LOGO_SILK_NVIDIA_I0400X0240_9
LOGO_SILK_NVIDIA_I0400X0240_5
LOGO_SILK_NVIDIA_I0400X0240
LOGO_SILK_NVIDIA_I0400X0240_2
LOGO_SILK_NVIDIA_I0400X0240_7
LOGO_SILK_NVIDIA_I0400X0240_6
LOGO_SILK_NVIDIA_I0400X0240_11
LOGO_SILK_NVIDIA_I0400X0240_4
LS_CTUVUS_0500X0500_SIMPLE_2
LS_CTUVUS_0500X0500_SIMPLE
LS_CTUVUS_0500X0500_SIMPLE_4
LS_CTUVUS_0500X0500_SIMPLE_3
LOGO_SILK_UKRAINE_0500X0500_2
LOGO_SILK_UKRAINE_0500X0500
LOGO_SILK_SAA_1206X0540_5
LOGO_SILK_SAA_1206X0540_7
LOGO_SILK_SAA_1206X0540
LOGO_SILK_SAA_1206X0540_6
LOGO_SILK_SAA_1206X0540_8
LOGO_SILK_SAA_1206X0540_4
LOGO_SILK_SAA_1206X0540_3
LOGO_SILK_SAA_1206X0540_2
LOGO_SILK_SAA_1206X0540_9
0402_SHUNT_NO_2 x 3
0402_SHUNT_NO x 3
0402_SHORT x 4
LOGO_SILK_EAC_050X050_2
LOGO_SILK_EAC_050X050
LOGO_SILK_EAC_050X050_3
LOGO_LABEL_PPID_0180X0050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
