happymonk-ai/enclosures/Project/New Main Module Enclosure/Jetson_Nano_2GB_DevKit_P3541_3D_STEP_Model_nv/064-0473-000_1.sldasm

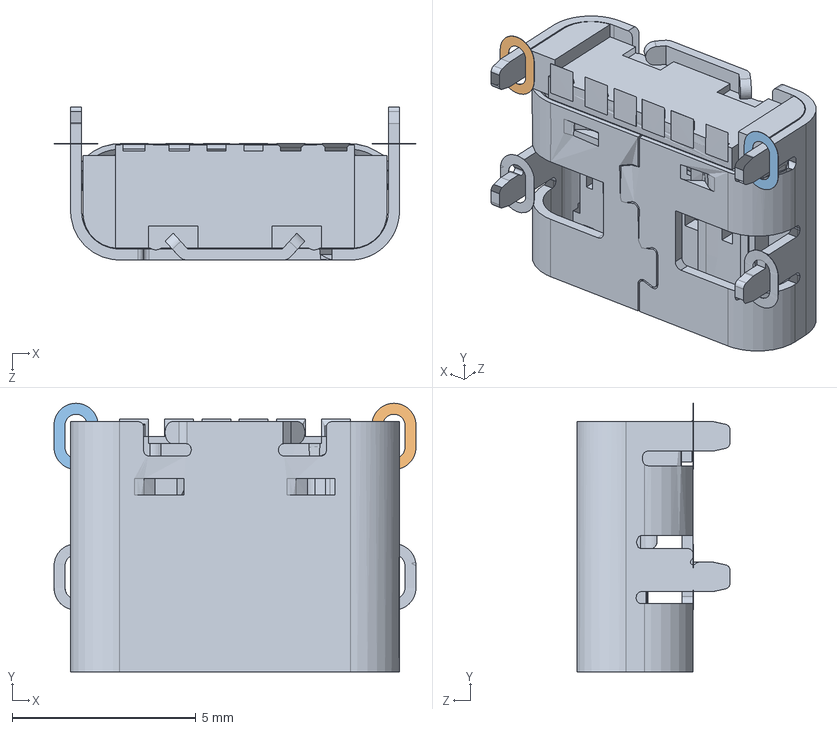
[picture p55: CAD file, 2021-11-02]
Project/New Main Module Enclosure/Jetson_Nano_2GB_DevKit_P3541_3D_STEP_Model_nv/064-0473-000_1.sldasm
9.84 x 7.30 x 4.16 mm
