happymonk-ai/enclosures/Dependencies/Dowloaded files/RMCV9038.stp

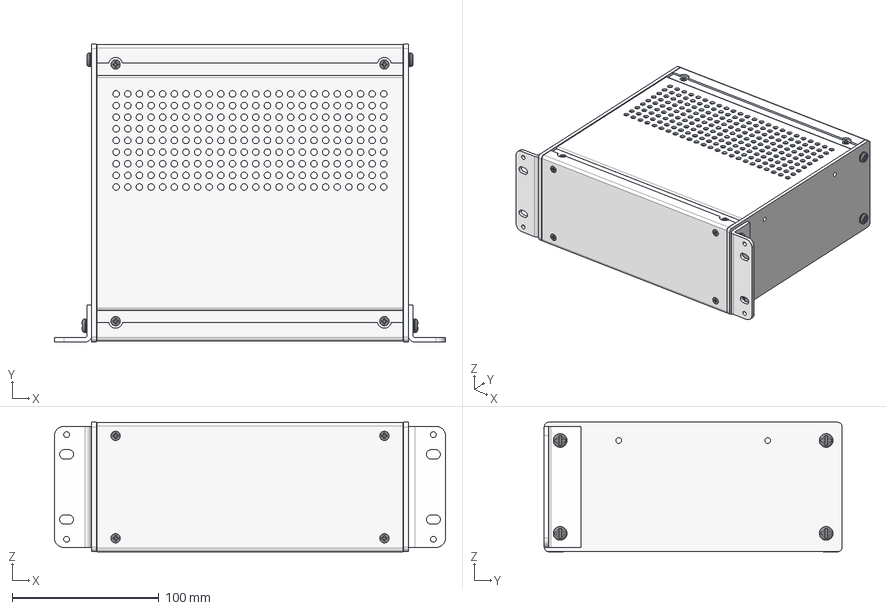
[picture p56: CAD file, 2021-09-28]
Dependencies/Dowloaded files/RMCV9038.stp
266.7 x 203.4 x 88.4 mm
COM53880 x 2
COM53877-1 x 2
COM53875-2 x 2
COM53878-2 x 2
SCS19498 x 8
SCS19535 x 16
NTS16752 x 12
NTS16847 x 12
COM53874-1 x 4
