happymonk-ai/enclosures/Project/Full Rack/Antenna/NRF24L01L + Antenna 2.4 GHz/Antenna top.SLDPRT

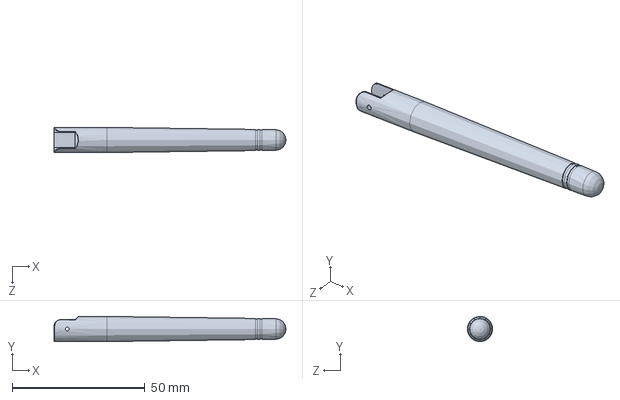
[picture p57: CAD file, 2021-09-28]
Project/Full Rack/Antenna/NRF24L01L + Antenna 2.4 GHz/Antenna top.SLDPRT
87.5 x 9.50 x 9.50 mm
