happymonk-ai/enclosures/Project/Full Rack/ERC12864-655/Adhesive.SLDPRT

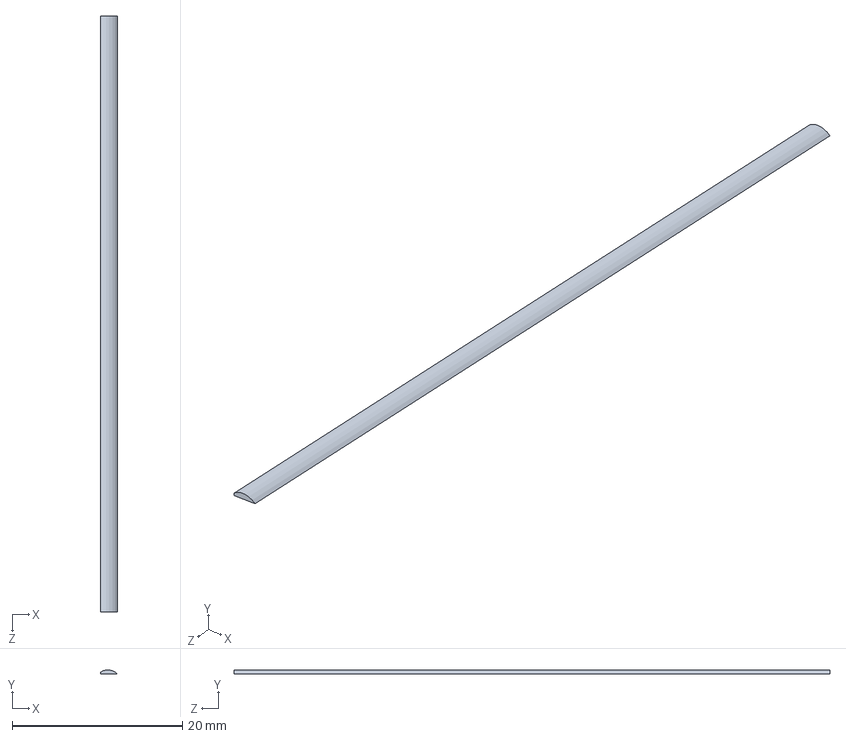
[picture p58: CAD file, 2021-09-28]
Project/Full Rack/ERC12864-655/Adhesive.SLDPRT
2.00 x 0.485 x 70.0 mm
