happymonk-ai/enclosures/Project/Full Rack/led-5mm-through-hole-1.snapshot.1/LED´s 5mm TH.stp

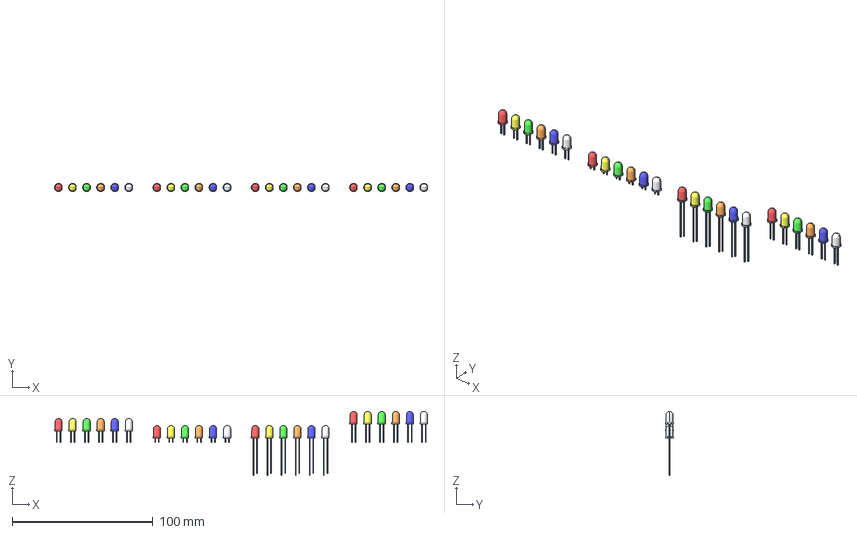
[picture p59: CAD file, 2021-09-28]
Project/Full Rack/led-5mm-through-hole-1.snapshot.1/LED´s 5mm TH.stp
265.5 x 5.84 x 45.6 mm
