happymonk-ai/enclosures/Project/Half Rack/tactile-switch-smd-6mm-series-1.snapshot.2/Tactal Switch - SMD (6mmx 6mmx 4.3mm) - Marked.SLDPRT

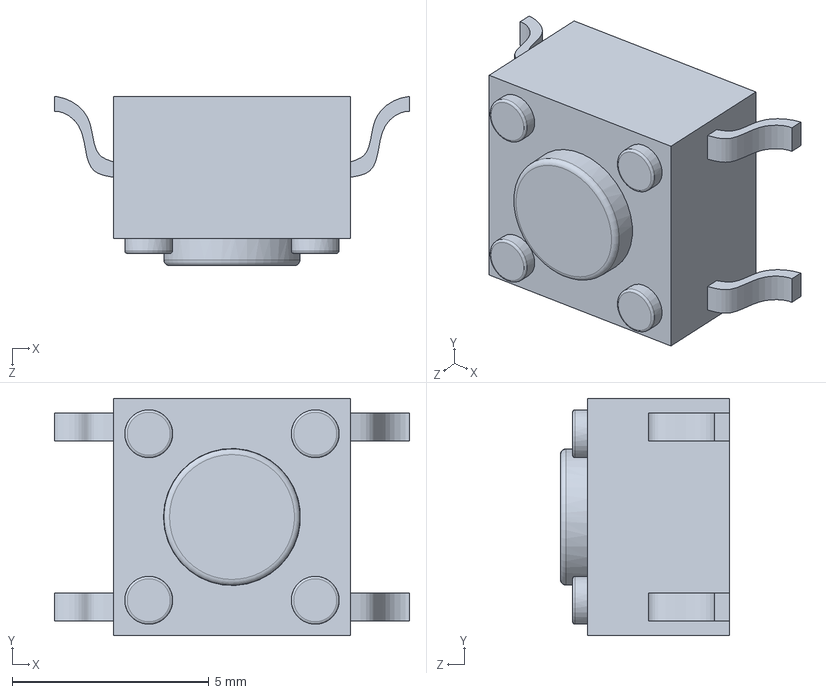
[picture p61: CAD file, 2021-09-29]
Project/Half Rack/tactile-switch-smd-6mm-series-1.snapshot.2/Tactal Switch - SMD (6mmx 6mmx 4.3mm) - Marked.SLDPRT
9.02 x 6.03 x 4.30 mm
