happymonk-ai/enclosures/Project/New Main Module Enclosure/Ethernet cable - 1/909.STEP

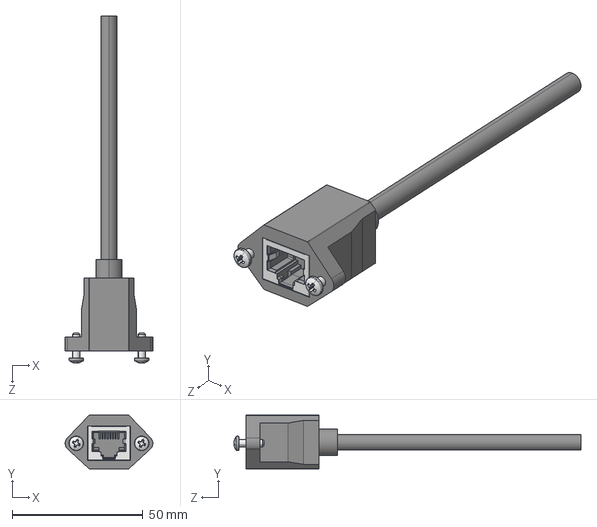
[picture p62: CAD file, 2021-10-27]
Project/New Main Module Enclosure/Ethernet cable - 1/909.STEP
33.5 x 20.5 x 132.6 mm
