happymonk-ai/enclosures/Project/New Main Module Enclosure/Ethernet RJ45/Just Ethernet RJ-45 connector.SLDPRT

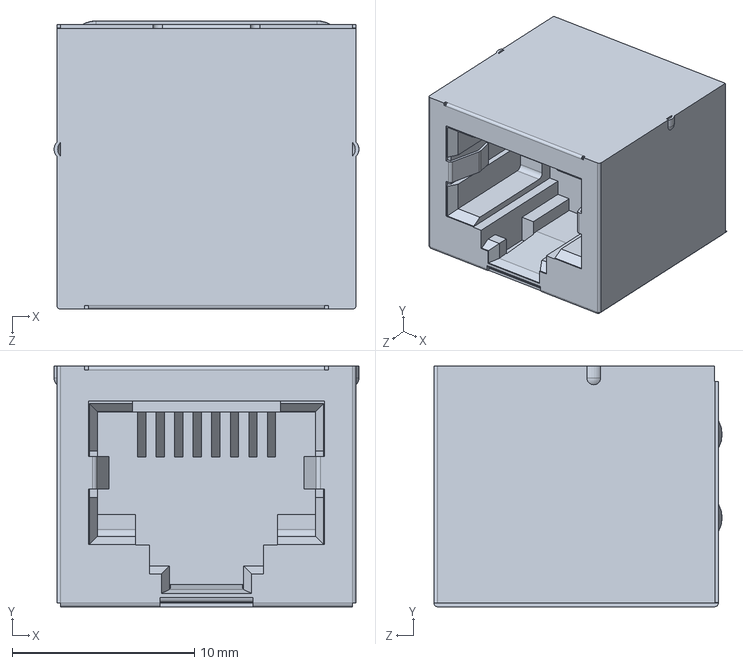
[picture p63: CAD file, 2021-11-02]
Project/New Main Module Enclosure/Ethernet RJ45/Just Ethernet RJ-45 connector.SLDPRT
16.7 x 13.2 x 15.8 mm
