happymonk-ai/enclosures/Project/New Main Module Enclosure/ethernet-switch-1.snapshot.3/Mercusys_MS105G.STEP

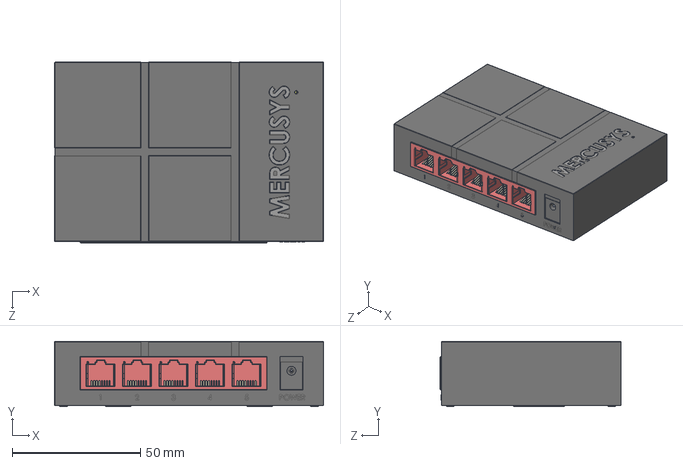
[picture p64: CAD file, 2021-11-02]
Project/New Main Module Enclosure/ethernet-switch-1.snapshot.3/Mercusys_MS105G.STEP
105.0 x 25.4 x 70.5 mm
