happymonk-ai/enclosures/Project/New Main Module Enclosure/power-connector-iec-c4-3-pins-1.snapshot.2/IEC-C4-3pins.SLDPRT

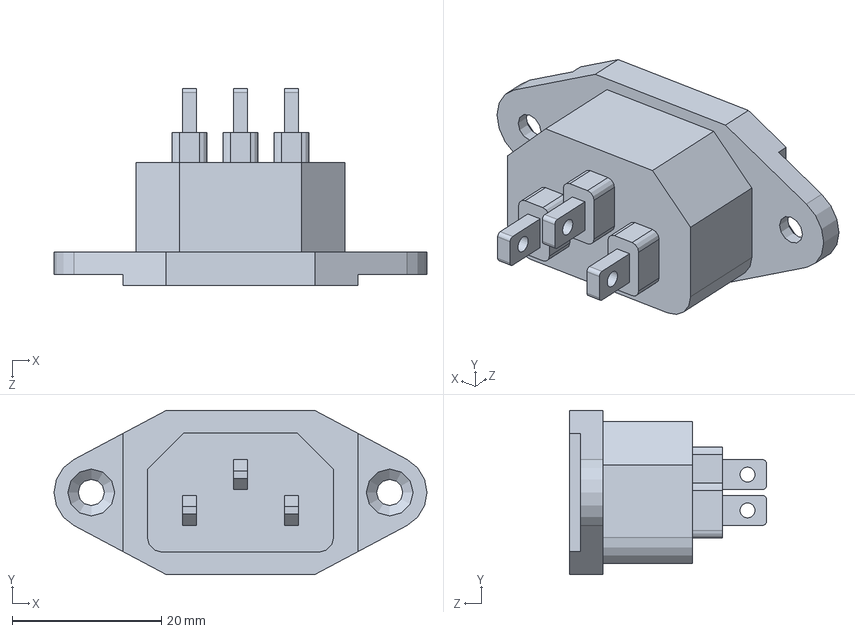
[picture p65: CAD file, 2021-10-27]
Project/New Main Module Enclosure/power-connector-iec-c4-3-pins-1.snapshot.2/IEC-C4-3pins.SLDPRT
50.0 x 22.0 x 26.4 mm
