happymonk-ai/enclosures/Project/New Main Module Enclosure/selector-switch-ss12d00-1.snapshot.3/Selector Switch - SS23D07.stp

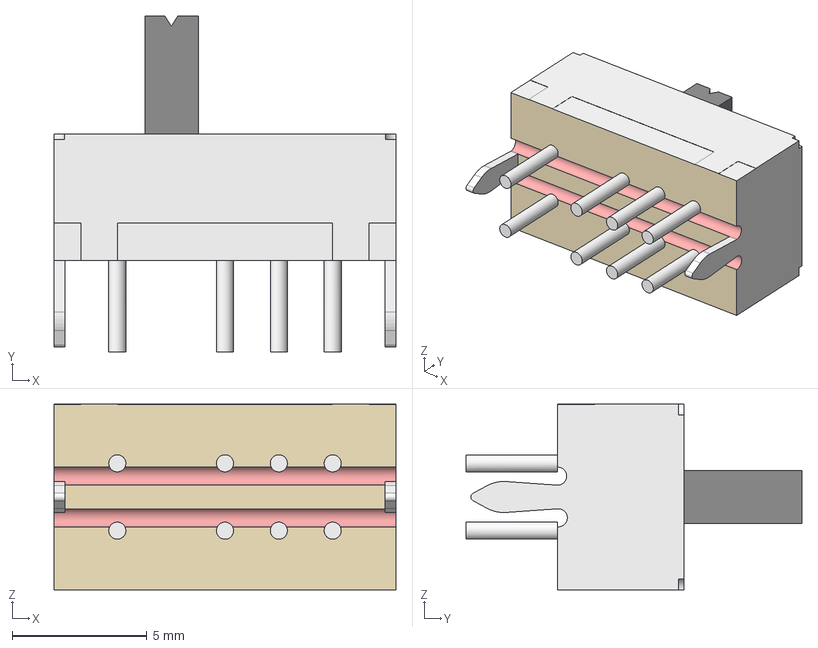
[picture p66: CAD file, 2021-09-28]
Project/New Main Module Enclosure/selector-switch-ss12d00-1.snapshot.3/Selector Switch - SS23D07.stp
12.7 x 12.5 x 6.90 mm
