happymonk-ai/enclosures/Project/New Main Module Enclosure/USB RJ45/USB Femal to Female Connector.SLDPRT

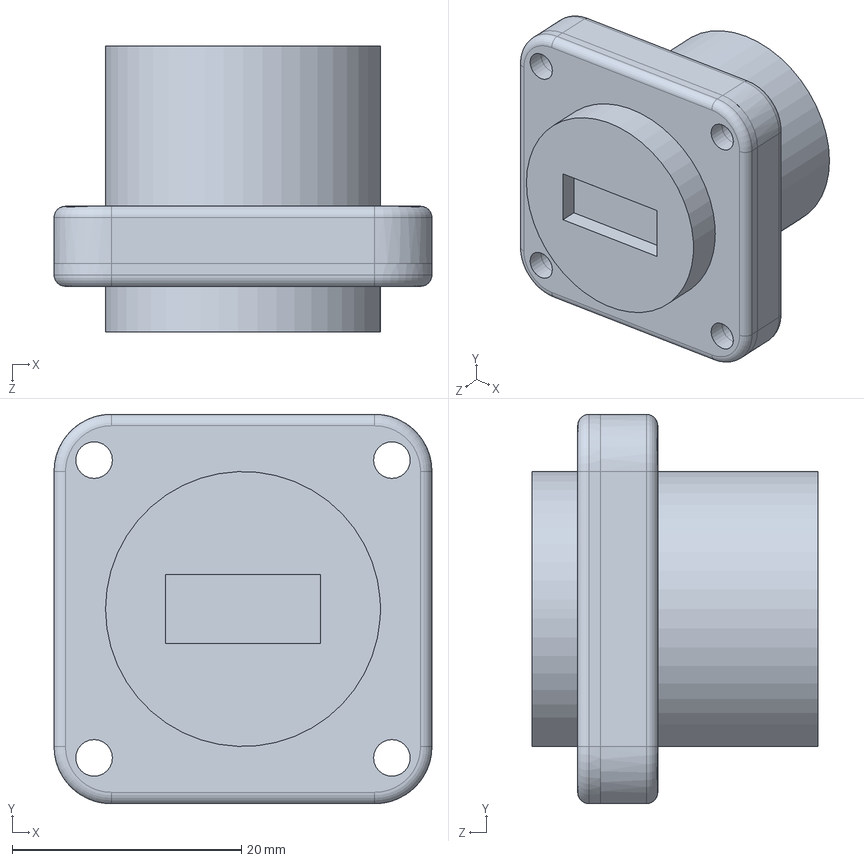
[picture p67: CAD file, 2021-11-02]
Project/New Main Module Enclosure/USB RJ45/USB Femal to Female Connector.SLDPRT
33.0 x 34.0 x 25.0 mm
