happymonk-ai/enclosures/Project/New Main Module Enclosure/usb-a-female-short-body-1.snapshot.1/USB-A母座短#1.STEP

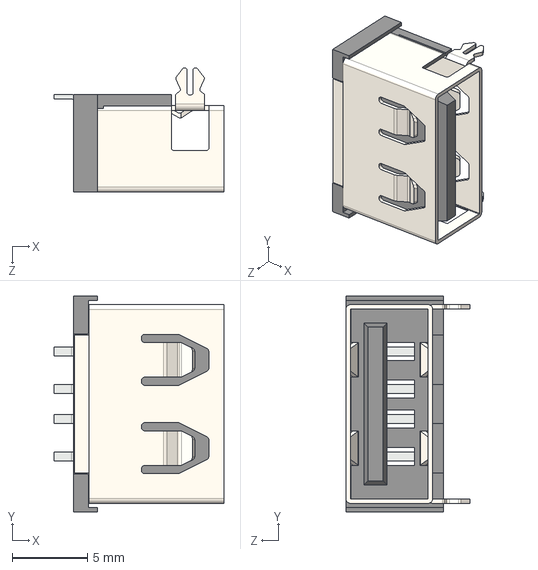
[picture p68: CAD file, 2021-11-02]
Project/New Main Module Enclosure/usb-a-female-short-body-1.snapshot.1/USB-A母座短#1.STEP
11.3 x 14.4 x 8.28 mm
