happymonk-ai/enclosures/Project/New Main Module Enclosure/usb-female-panel-mount-connector-1.snapshot.9/USB Type A - panel mount.STEP

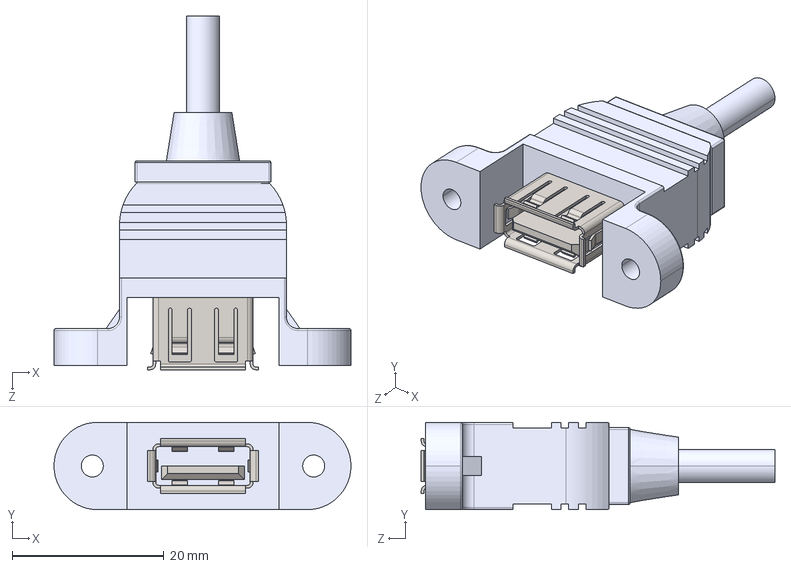
[picture p69: CAD file, 2021-09-28]
Project/New Main Module Enclosure/usb-female-panel-mount-connector-1.snapshot.9/USB Type A - panel mount.STEP
39.1 x 11.5 x 46.6 mm
