happymonk-ai/enclosures/Project/Battery Pack and Draft files/Project/Front Plate - 1.sldprt

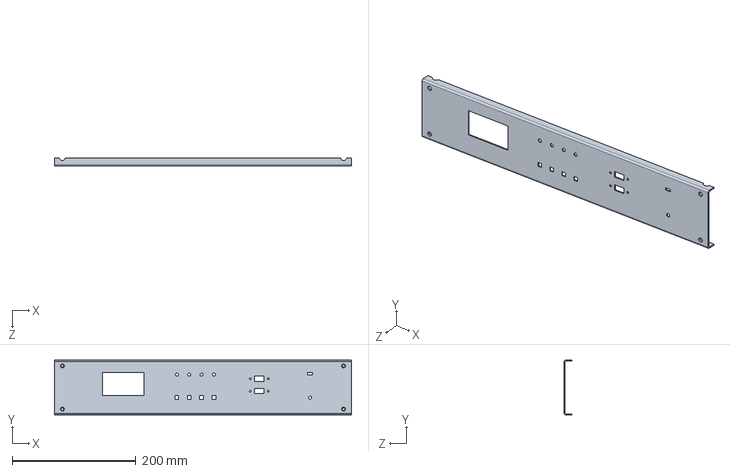
[picture p70: CAD file, 2021-10-08]
Project/Battery Pack and Draft files/Project/Front Plate - 1.sldprt
480.0 x 88.3 x 12.7 mm
