happymonk-ai/enclosures/Project/Full Rack/Antenna/NRF24L01L + Antenna 2.4 GHz/Antenna base.SLDPRT

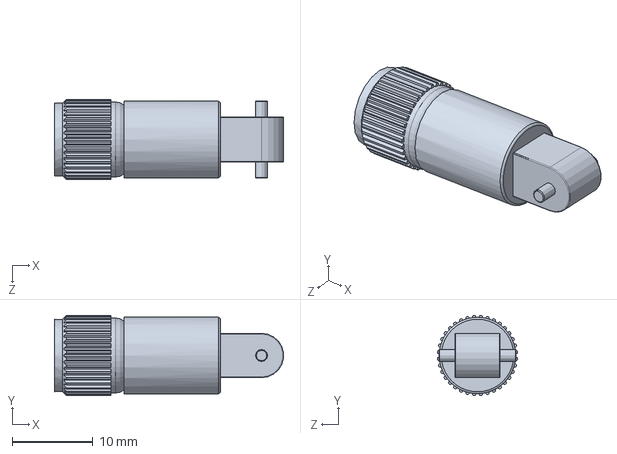
[picture p71: CAD file, 2021-09-28]
Project/Full Rack/Antenna/NRF24L01L + Antenna 2.4 GHz/Antenna base.SLDPRT
28.4 x 9.98 x 9.98 mm
