happymonk-ai/enclosures/Project/Half Rack/Antenna/NRF24L01L + Antenna 2.4 GHz/NRF24L01L.SLDPRT

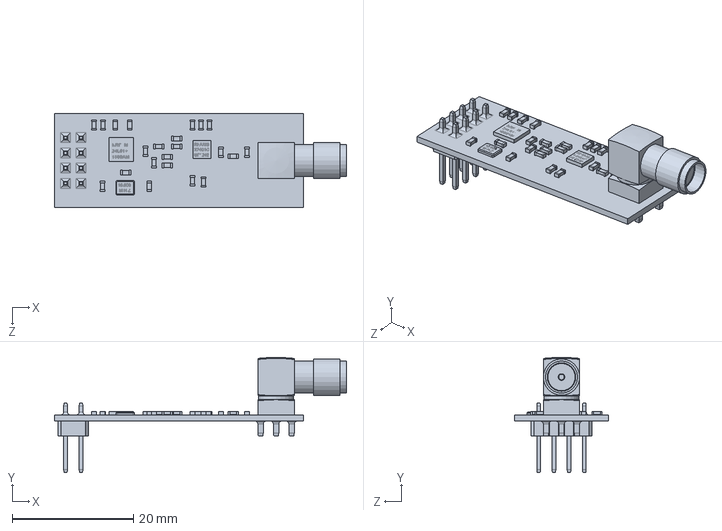
[picture p72: CAD file, 2021-09-29]
Project/Half Rack/Antenna/NRF24L01L + Antenna 2.4 GHz/NRF24L01L.SLDPRT
48.1 x 19.0 x 15.5 mm
