happymonk-ai/enclosures/Project/Half Rack/ERC12864-655/NC Pin.SLDPRT

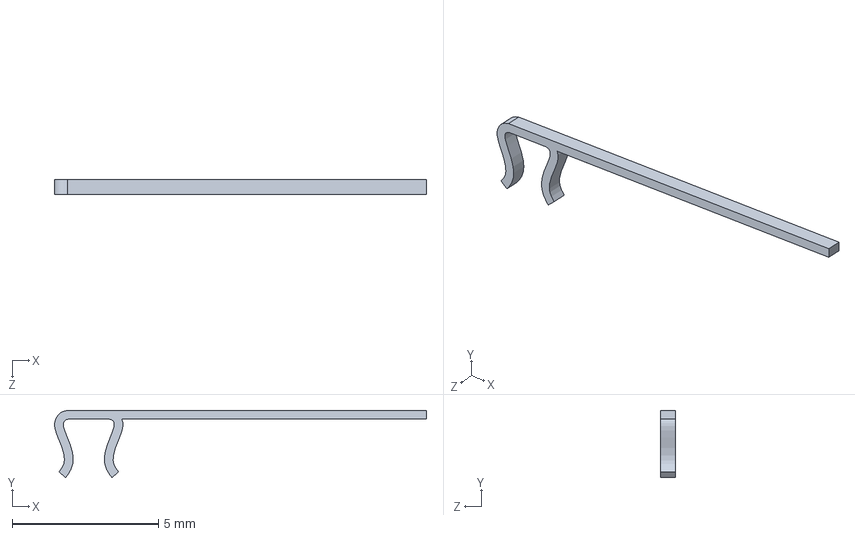
[picture p73: CAD file, 2021-09-29]
Project/Half Rack/ERC12864-655/NC Pin.SLDPRT
12.7 x 2.30 x 0.5 mm
