happymonk-ai/enclosures/Project/New Main Module Enclosure/Ethernet RJ45/Ethernet Female to Female Input RJ45.SLDPRT

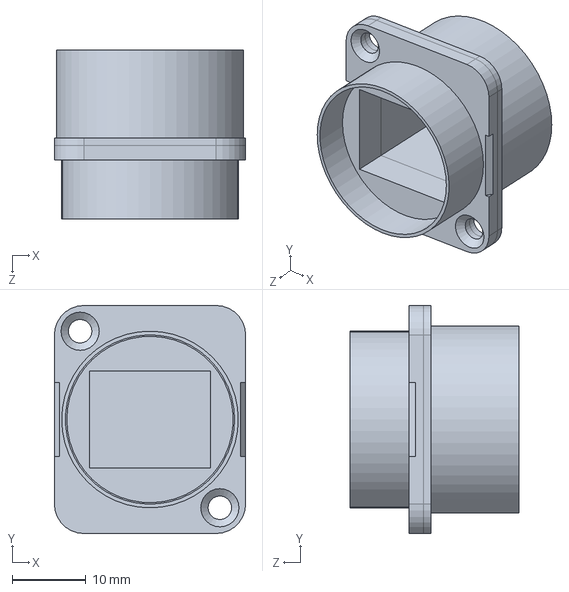
[picture p74: CAD file, 2021-11-02]
Project/New Main Module Enclosure/Ethernet RJ45/Ethernet Female to Female Input RJ45.SLDPRT
26.0 x 31.0 x 23.0 mm
