happymonk-ai/enclosures/Project/New Main Module Enclosure/Raspberry-pi-EVE-MINI-PCLe HAT.SLDPRT

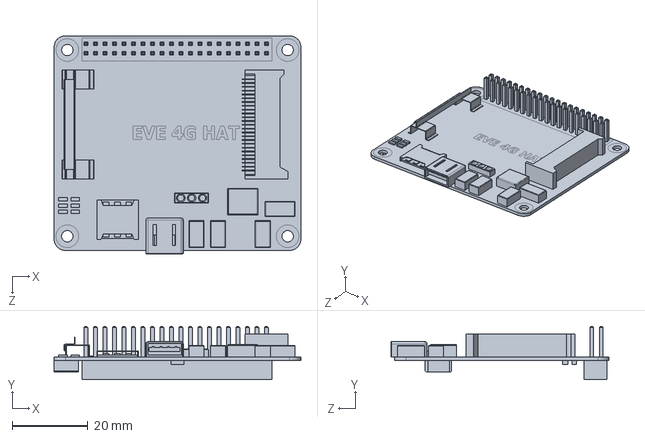
[picture p75: CAD file, 2021-11-02]
Project/New Main Module Enclosure/Raspberry-pi-EVE-MINI-PCLe HAT.SLDPRT
65.0 x 14.0 x 57.5 mm
