happymonk-ai/enclosures/Project/New Main Module Enclosure/selector-switch-ss12d00-1.snapshot.3/Selector Switch - SS12D00.stp

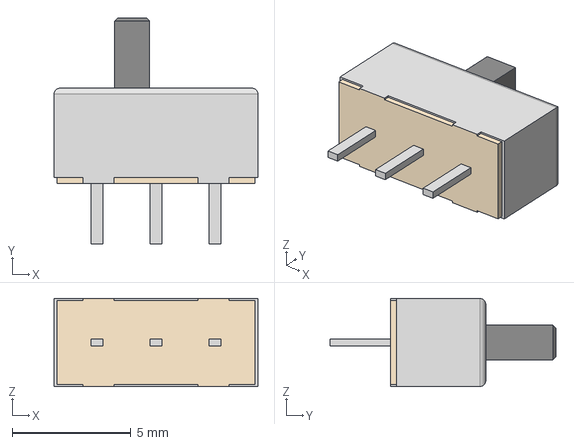
[picture p76: CAD file, 2021-09-28]
Project/New Main Module Enclosure/selector-switch-ss12d00-1.snapshot.3/Selector Switch - SS12D00.stp
8.59 x 9.50 x 3.71 mm
