happymonk-ai/enclosures/Project/Full Rack/tactile-switch-smd-6mm-series-1.snapshot.2/Tactal Switch - SMD (6mmx 6mmx 5mm) - Marked.stp

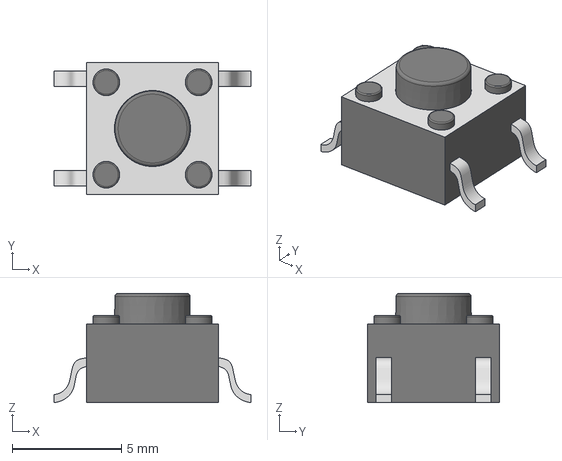
[picture p77: CAD file, 2021-09-28]
Project/Full Rack/tactile-switch-smd-6mm-series-1.snapshot.2/Tactal Switch - SMD (6mmx 6mmx 5mm) - Marked.stp
9.02 x 6.03 x 5.00 mm
