happymonk-ai/enclosures/Project/New Main Module Enclosure/HDMI RJ45/HDMI Female Female Connector.SLDPRT

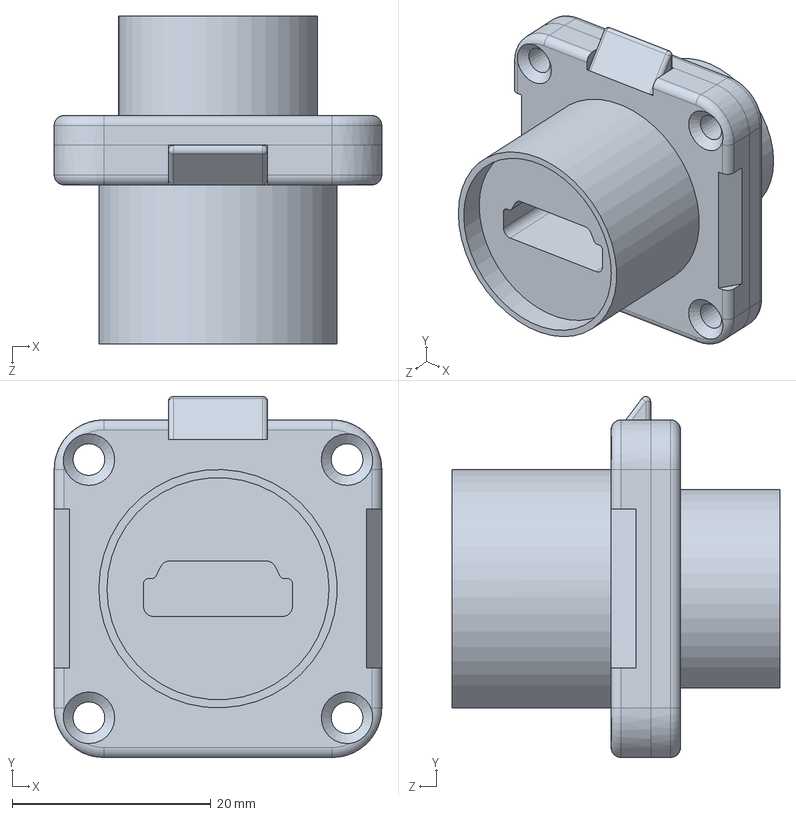
[picture p78: CAD file, 2021-11-02]
Project/New Main Module Enclosure/HDMI RJ45/HDMI Female Female Connector.SLDPRT
33.0 x 36.4 x 33.0 mm
