happymonk-ai/enclosures/Project/New Main Module Enclosure/selector-switch-ss12d00-1.snapshot.3/Selector Switch - MSS22D18.stp

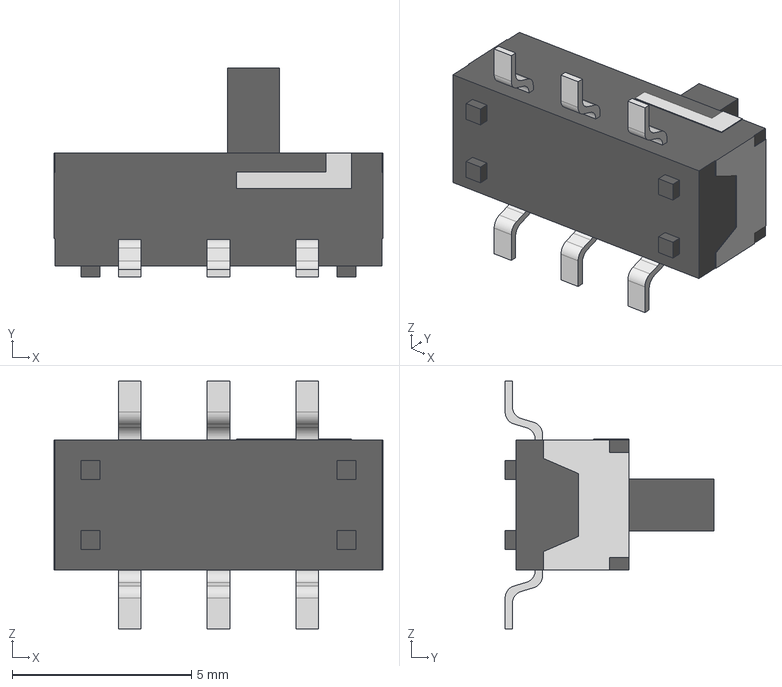
[picture p79: CAD file, 2021-09-28]
Project/New Main Module Enclosure/selector-switch-ss12d00-1.snapshot.3/Selector Switch - MSS22D18.stp
9.17 x 5.82 x 6.91 mm
