happymonk-ai/enclosures/Project/New Main Module Enclosure/usb-a-female-short-body-1.snapshot.1/USB-AÄ¸×ù¶Ì#1_4.sldprt

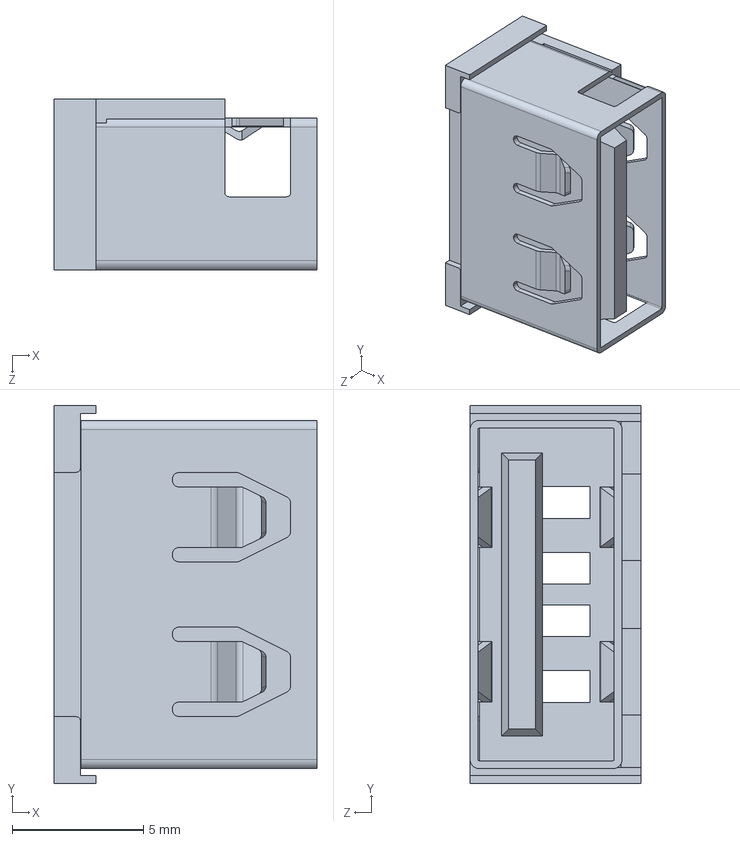
[picture p80: CAD file, 2021-11-02]
Project/New Main Module Enclosure/usb-a-female-short-body-1.snapshot.1/USB-AÄ¸×ù¶Ì#1_4.sldprt
10.0 x 14.4 x 6.50 mm
