happymonk-ai/enclosures/Project/Full Rack/2U Full Rack Enclosure/Front Plate - 1.sldprt

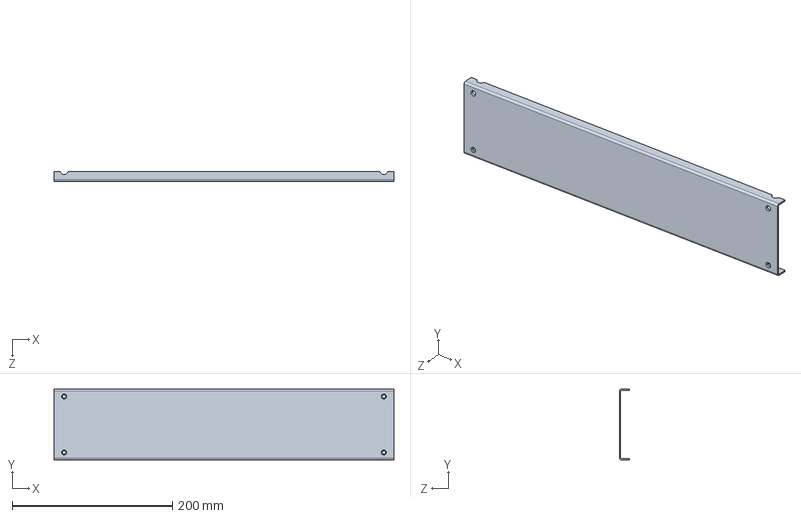
[picture p81: CAD file, 2021-09-29]
Project/Full Rack/2U Full Rack Enclosure/Front Plate - 1.sldprt
424.6 x 88.3 x 12.7 mm
