happymonk-ai/enclosures/Project/New Main Module Enclosure/selector-switch-ss12d00-1.snapshot.3/Selector Switch - MSK1103.stp

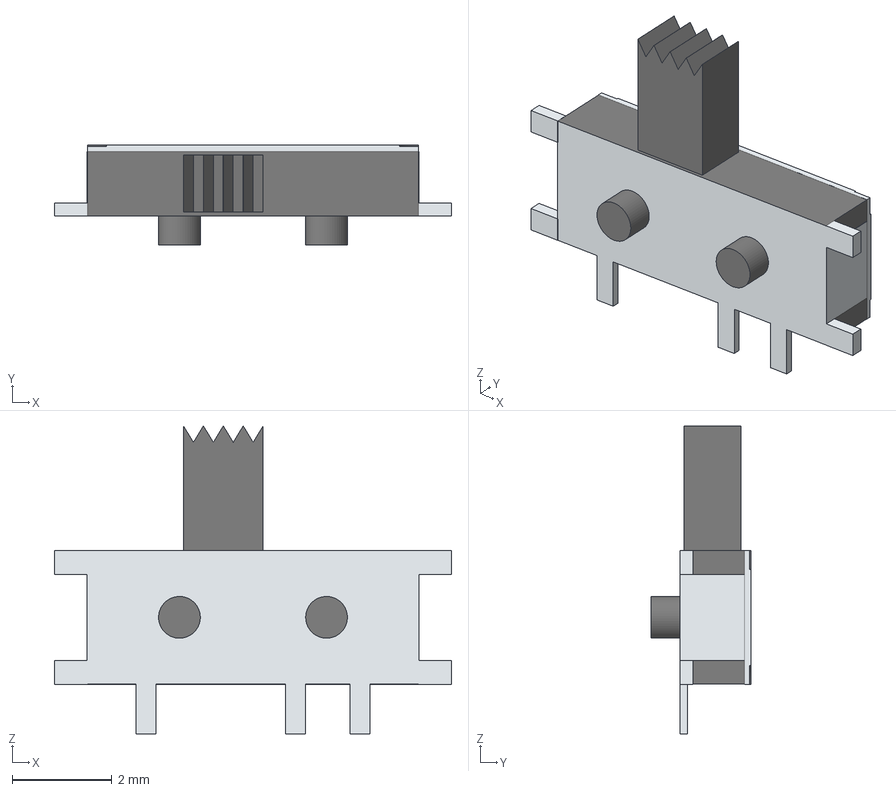
[picture p83: CAD file, 2021-09-28]
Project/New Main Module Enclosure/selector-switch-ss12d00-1.snapshot.3/Selector Switch - MSK1103.stp
7.98 x 2.01 x 6.19 mm
