happymonk-ai/enclosures/Project/Battery Pack and Draft files/1U Full rack/Front Part.sldprt

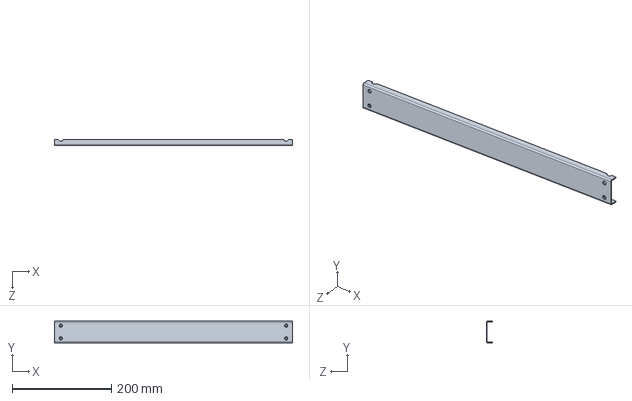
[picture p84: CAD file, 2021-10-08]
Project/Battery Pack and Draft files/1U Full rack/Front Part.sldprt
480.0 x 43.9 x 12.7 mm
