happymonk-ai/enclosures/Project/Full Rack/tactile-switch-smd-6mm-series-1.snapshot.2/Tactal Switch - SMD (6mmx 6mmx 10mm) - Marked.stp

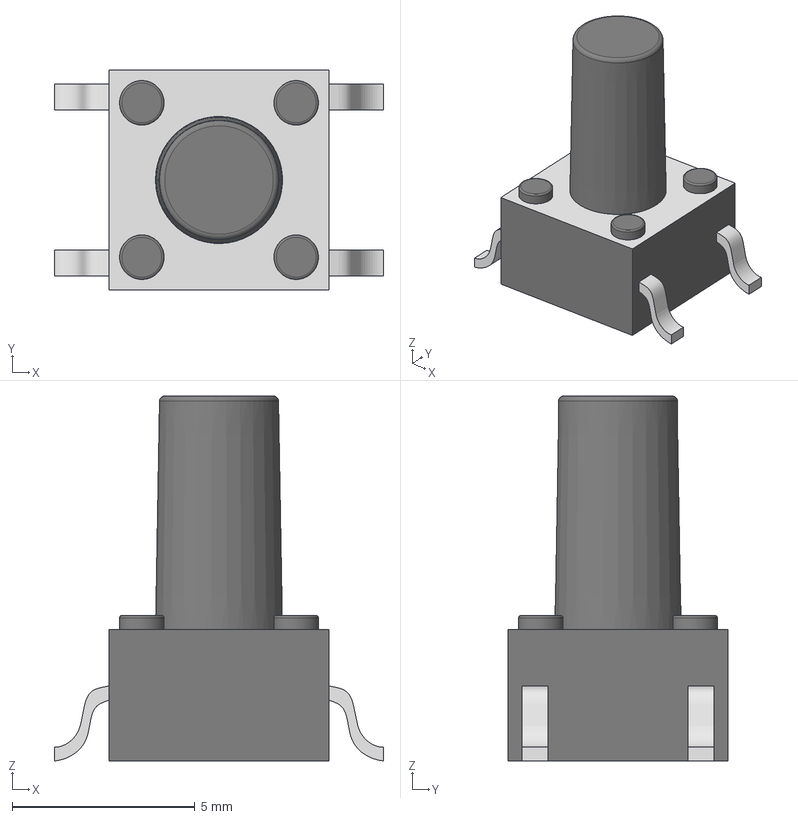
[picture p85: CAD file, 2021-09-28]
Project/Full Rack/tactile-switch-smd-6mm-series-1.snapshot.2/Tactal Switch - SMD (6mmx 6mmx 10mm) - Marked.stp
9.02 x 6.03 x 10.0 mm
