happymonk-ai/enclosures/Project/New Main Module Enclosure/selector-switch-ss12d00-1.snapshot.3/Selector Switch -.stp

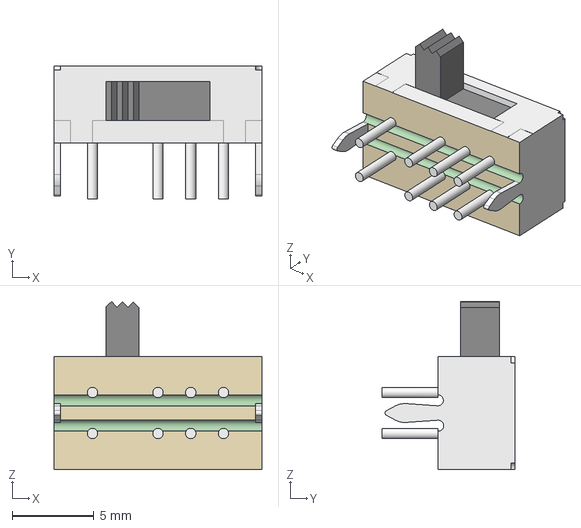
[picture p86: CAD file, 2021-09-28]
Project/New Main Module Enclosure/selector-switch-ss12d00-1.snapshot.3/Selector Switch -.stp
12.7 x 8.10 x 10.3 mm
