happymonk-ai/enclosures/Project/New Main Module Enclosure/led-5mm-red-through-hole-1.snapshot.10/PlasticHousing - Reverse Engineered.SLDPRT

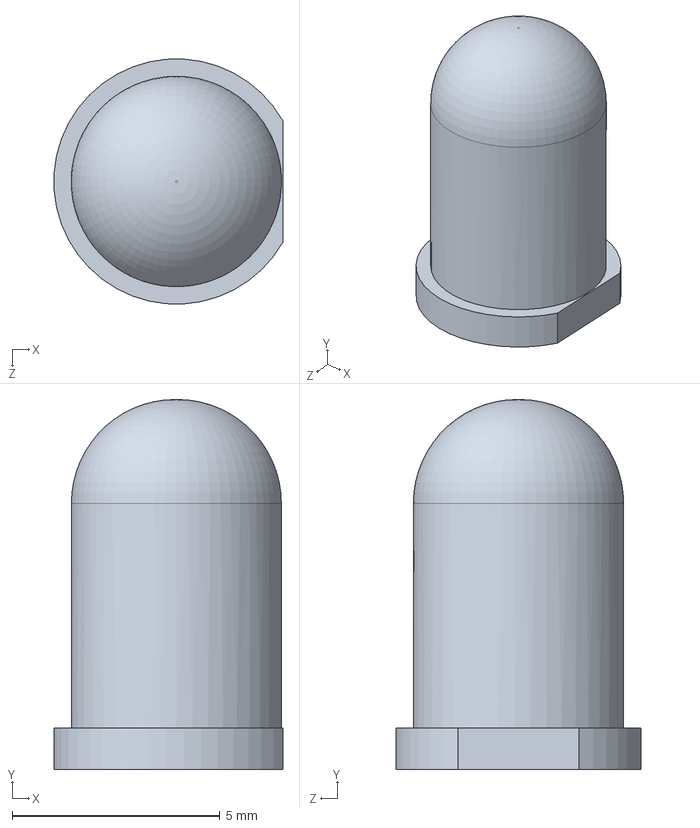
[picture p88: CAD file, 2021-09-28]
Project/New Main Module Enclosure/led-5mm-red-through-hole-1.snapshot.10/PlasticHousing - Reverse Engineered.SLDPRT
5.51 x 8.90 x 5.89 mm
