happymonk-ai/enclosures/Project/New Main Module Enclosure/led-5mm-red-through-hole-1.snapshot.10/Leg-1.SLDPRT

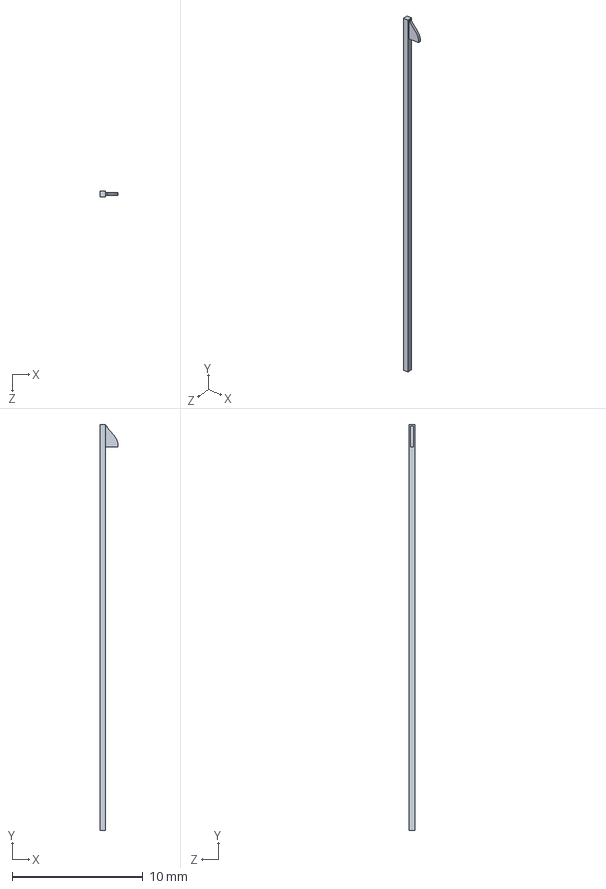
[picture p91: CAD file, 2021-09-28]
Project/New Main Module Enclosure/led-5mm-red-through-hole-1.snapshot.10/Leg-1.SLDPRT
1.40 x 31.0 x 0.45 mm
