happymonk-ai/enclosures/Project/New Main Module Enclosure/raspberry-pi-4-port-usb-hub-hat-1.snapshot.3/PCB 65x30x1.6.SLDPRT

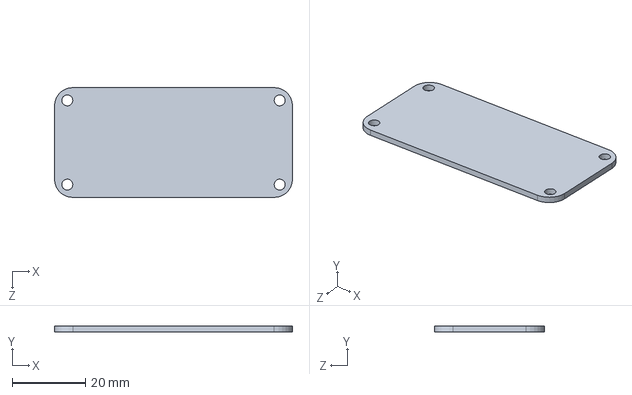
[picture p92: CAD file, 2021-10-27]
Project/New Main Module Enclosure/raspberry-pi-4-port-usb-hub-hat-1.snapshot.3/PCB 65x30x1.6.SLDPRT
65.0 x 1.60 x 30.0 mm
