happymonk-ai/enclosures/(list of files, cad)

Other CAD files:
Project/Full Rack/Antenna/NRF24L01L + Antenna 2.4 GHz/NRF24L01L+Antenna.SLDASM
Project/New Main Module Enclosure/led-5mm-red-through-hole-1.snapshot.10/Legs.sldasm
Project/Full Rack/Antenna/NRF24L01L + Antenna 2.4 GHz/Antenna assy.SLDASM
Project/New Main Module Enclosure/Jetson_Nano_2GB_DevKit_P3541_3D_STEP_Model_nv/064-0474-000_1.sldasm
Project/New Main Module Enclosure/hdmi-extender-connector-1.snapshot.13/Connector.sldasm
Project/New Main Module Enclosure/hdmi-extender-connector-1.snapshot.13/Pins.sldasm
Project/New Main Module Enclosure/Jetson_Nano_2GB_DevKit_P3541_3D_STEP_Model_nv/064-0476-000_1.sldasm
Project/New Main Module Enclosure/Jetson_Nano_2GB_DevKit_P3541_3D_STEP_Model_nv/LOGO_SILK_RCM_040X030.sldasm
Project/Half Rack/8-port-rj45-socket-1.snapshot.2/RJ45 x 16.sldasm
Project/Full Rack/8-port-rj45-socket-1.snapshot.2/Socket.sldasm
Project/New Main Module Enclosure/Jetson_Nano_2GB_DevKit_P3541_3D_STEP_Model_nv/080-1656-000_3.sldasm
Project/New Main Module Enclosure/Jetson_Nano_2GB_DevKit_P3541_3D_STEP_Model_nv/682-13450_PORG_ME_THER_ASSY_ASM.sldasm
Project/New Main Module Enclosure/Jetson_Nano_2GB_DevKit_P3541_3D_STEP_Model_nv/LS_CTUVUS_0500X0500_SIMPLE.sldasm
Project/New Main Module Enclosure/Jetson_Nano_2GB_DevKit_P3541_3D_STEP_Model_nv/PORG_HSK_ASSY_ASM.sldasm
Project/Half Rack/8-port-rj45-socket-1.snapshot.2/Socket.sldasm
Project/Full Rack/8-port-rj45-socket-1.snapshot.2/RJ45 x 16.sldasm
Project/New Main Module Enclosure/Jetson_Nano_2GB_DevKit_P3541_3D_STEP_Model_nv/FID_40_80SM.sldasm
Project/New Main Module Enclosure/Jetson_Nano_2GB_DevKit_P3541_3D_STEP_Model_nv/074-0239-000_1.sldasm
Project/New Main Module Enclosure/Jetson_Nano_2GB_DevKit_P3541_3D_STEP_Model_nv/LOGO_SILK_ROHS_I0300X0153.sldasm
Project/New Main Module Enclosure/Jetson_Nano_2GB_DevKit_P3541_3D_STEP_Model_nv/LOGO_SILK_CE_I0175X0160.sldasm
Project/New Main Module Enclosure/Jetson_Nano_2GB_DevKit_P3541_3D_STEP_Model_nv/LOGO_SILK_SAA_1206X0540.sldasm
Project/New Main Module Enclosure/Jetson_Nano_2GB_DevKit_P3541_3D_STEP_Model_nv/090-0243-000_1.sldasm
Project/New Main Module Enclosure/Jetson_Nano_2GB_DevKit_P3541_3D_STEP_Model_nv/LOGO_SILK_BSMI_I0138H.sldasm
Project/New Main Module Enclosure/Jetson_Nano_2GB_DevKit_P3541_3D_STEP_Model_nv/LOGO_SILK_EAC_050X050.sldasm
Project/New Main Module Enclosure/Jetson_Nano_2GB_DevKit_P3541_3D_STEP_Model_nv/642-13541_BATUU_SYS_BOM_ASM.sldasm
Project/New Main Module Enclosure/Jetson_Nano_2GB_DevKit_P3541_3D_STEP_Model_nv/LOGO_SILK_ROHS_D050_CHINA.sldasm
Project/New Main Module Enclosure/Jetson_Nano_2GB_DevKit_P3541_3D_STEP_Model_nv/LOGO_SILK_UKRAINE_0500X0500.sldasm
Project/New Main Module Enclosure/Jetson_Nano_2GB_DevKit_P3541_3D_STEP_Model_nv/LOGO_SILK_WEEE_0485X0683.sldasm
Project/New Main Module Enclosure/Jetson_Nano_2GB_DevKit_P3541_3D_STEP_Model_nv/LOGO_SILK_VCCI_I0300X0225.sldasm
Project/New Main Module Enclosure/Jetson_Nano_2GB_DevKit_P3541_3D_STEP_Model_nv/0402_SHUNT_NO.sldasm
Project/New Main Module Enclosure/Jetson_Nano_2GB_DevKit_P3541_3D_STEP_Model_nv/LOGO_SILK_NVIDIA_I0400X0240.sldasm
Project/New Main Module Enclosure/Jetson_Nano_2GB_DevKit_P3541_3D_STEP_Model_nv/699-13448_PORG_MODULE_PCB_ASSY_ASM.sldasm
Project/New Main Module Enclosure/Jetson_Nano_2GB_DevKit_P3541_3D_STEP_Model_nv/600-13448_PORG_MODULE_PCB_ASSY_ASM.sldasm
Project/New Main Module Enclosure/Jetson_Nano_2GB_DevKit_P3541_3D_STEP_Model_nv/074-0259-000_1.sldasm
Project/New Main Module Enclosure/Jetson_Nano_2GB_DevKit_P3541_3D_STEP_Model_nv/LOGO_SILK_P3542.sldasm
Project/New Main Module Enclosure/Jetson_Nano_2GB_DevKit_P3541_3D_STEP_Model_nv/220-0146-000_2.sldasm
Project/Full Rack/8-port-rj45-socket-1.snapshot.2/Socket_30.sldprt
Project/Half Rack/8-port-rj45-socket-1.snapshot.2/Socket_75.sldprt
Project/New Main Module Enclosure/hdmi-extender-connector-1.snapshot.13/Pins_19.sldprt
Project/New Main Module Enclosure/Jetson_Nano_2GB_DevKit_P3541_3D_STEP_Model_nv/080-1656-000_3_27.sldprt
Project/New Main Module Enclosure/power-supply-24vdc-10a-1.snapshot.2/Power Supply 24VDC 10A_22.sldprt
Project/New Main Module Enclosure/raspberry-pi-4-port-usb-hub-hat-1.snapshot.3/Mylar.sldprt
Project/Full Rack/8-port-rj45-socket-1.snapshot.2/RJ45 x 16_27.sldprt
Project/Full Rack/tactile-switch-smd-6mm-series-1.snapshot.2/Tactal Switch - SMD (6mmx 6mmx 4.3mm) - Marked.stp
Project/Half Rack/8-port-rj45-socket-1.snapshot.2/Socket_57.sldprt
Project/New Main Module Enclosure/hdmi-extender-connector-1.snapshot.13/Imported.sldprt
Project/New Main Module Enclosure/Jetson_Nano_2GB_DevKit_P3541_3D_STEP_Model_nv/080-1656-000_3_13.sldprt
Project/New Main Module Enclosure/led-5mm-red-through-hole-1.snapshot.10/Legs_2.sldprt
Project/New Main Module Enclosure/power-supply-24vdc-10a-1.snapshot.2/Power Supply 24VDC 10A_26.sldprt
Project/New Main Module Enclosure/raspberry-pi-4-port-usb-hub-hat-1.snapshot.3/6130xx21821_PIN.sldprt
Project/New Main Module Enclosure/usb-a-female-short-body-1.snapshot.1/USB-AÄ¸×ù¶Ì#1_6.sldprt
Project/Full Rack/8-port-rj45-socket-1.snapshot.2/Socket_87.sldprt
Project/Full Rack/Antenna/NRF24L01L + Antenna 2.4 GHz/NRF24L01L.SLDPRT
Project/Full Rack/ERC12864-655/NC Pin.SLDPRT
Project/Half Rack/8-port-rj45-socket-1.snapshot.2/Socket_10.sldprt
Project/New Main Module Enclosure/hdmi-extender-connector-1.snapshot.13/Pins_17.sldprt
Project/New Main Module Enclosure/Jetson_Nano_2GB_DevKit_P3541_3D_STEP_Model_nv/080-1656-000_3_135.sldprt
Project/New Main Module Enclosure/led-5mm-red-through-hole-1.snapshot.10/PlasticHousing.sldprt
Project/New Main Module Enclosure/power-supply-24vdc-10a-1.snapshot.2/Power Supply 24VDC 10A_29.sldprt
Project/Battery Pack and Draft files/Project/Front plate - 2.sldprt
Project/Full Rack/8-port-rj45-socket-1.snapshot.2/Socket_37.sldprt
Project/Half Rack/8-port-rj45-socket-1.snapshot.2/Socket_82.sldprt
Project/Half Rack/Antenna/NRF24L01L + Antenna 2.4 GHz/Antenna base.SLDPRT
Project/Half Rack/ERC12864-655/Adhesive.SLDPRT
Project/New Main Module Enclosure/hdmi-extender-connector-1.snapshot.13/Pins_9.sldprt
Project/New Main Module Enclosure/Jetson_Nano_2GB_DevKit_P3541_3D_STEP_Model_nv/080-1656-000_3_207.sldprt
Project/New Main Module Enclosure/Main Module 2U Rack Enclosure/Main Module 2U Full Rack/front enclose part-2.SLDPRT
Project/New Main Module Enclosure/power-supply-24vdc-10a-1.snapshot.2/Power Supply 24VDC 10A_23.sldprt
Project/Full Rack/8-port-rj45-socket-1.snapshot.2/Socket_69.sldprt
Project/Half Rack/8-port-rj45-socket-1.snapshot.2/Socket_45.sldprt
Project/Half Rack/Antenna/NRF24L01L + Antenna 2.4 GHz/Antenna top.SLDPRT
Project/New Main Module Enclosure/hdmi-extender-connector-1.snapshot.13/Pins_4.sldprt
Project/New Main Module Enclosure/Jetson_Nano_2GB_DevKit_P3541_3D_STEP_Model_nv/080-1656-000_3_44.sldprt
Project/New Main Module Enclosure/led-5mm-red-through-hole-1.snapshot.10/LED, 5mm, red v4.step
Project/New Main Module Enclosure/power-supply-24vdc-10a-1.snapshot.2/Power Supply 24VDC 10A_10.sldprt
Project/New Main Module Enclosure/usb-a-female-short-body-1.snapshot.1/USB-AÄ¸×ù¶Ì#1.sldprt
Project/Full Rack/8-port-rj45-socket-1.snapshot.2/Socket_91.sldprt
Project/Half Rack/8-port-rj45-socket-1.snapshot.2/RJ45 x 16_2.sldprt
Project/New Main Module Enclosure/hdmi-extender-connector-1.snapshot.13/Overmold.sldprt
Project/New Main Module Enclosure/power-supply-24vdc-10a-1.snapshot.2/Power Supply 24VDC 10A.sldprt
Project/New Main Module Enclosure/usb-a-female-short-body-1.snapshot.1/USB-AÄ¸×ù¶Ì#1_5.sldprt
Project/Full Rack/8-port-rj45-socket-1.snapshot.2/Socket_55.sldprt
Project/Half Rack/8-port-rj45-socket-1.snapshot.2/Socket_69.sldprt
Project/New Main Module Enclosure/Jetson_Nano_2GB_DevKit_P3541_3D_STEP_Model_nv/090-0096-000_1_2.sldprt
Project/New Main Module Enclosure/power-supply-24vdc-10a-1.snapshot.2/Power Supply 24VDC 10A_11.sldprt
Project/New Main Module Enclosure/usb-a-female-short-body-1.snapshot.1/USB-AÄ¸×ù¶Ì#1_3.sldprt
Project/Battery Pack and Draft files/1U Full rack/COM53875-1.sldprt
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
