happymonk-ai/enclosures/Project/Battery Pack and Draft files/Full rack 2U Enclosure Project.PDF

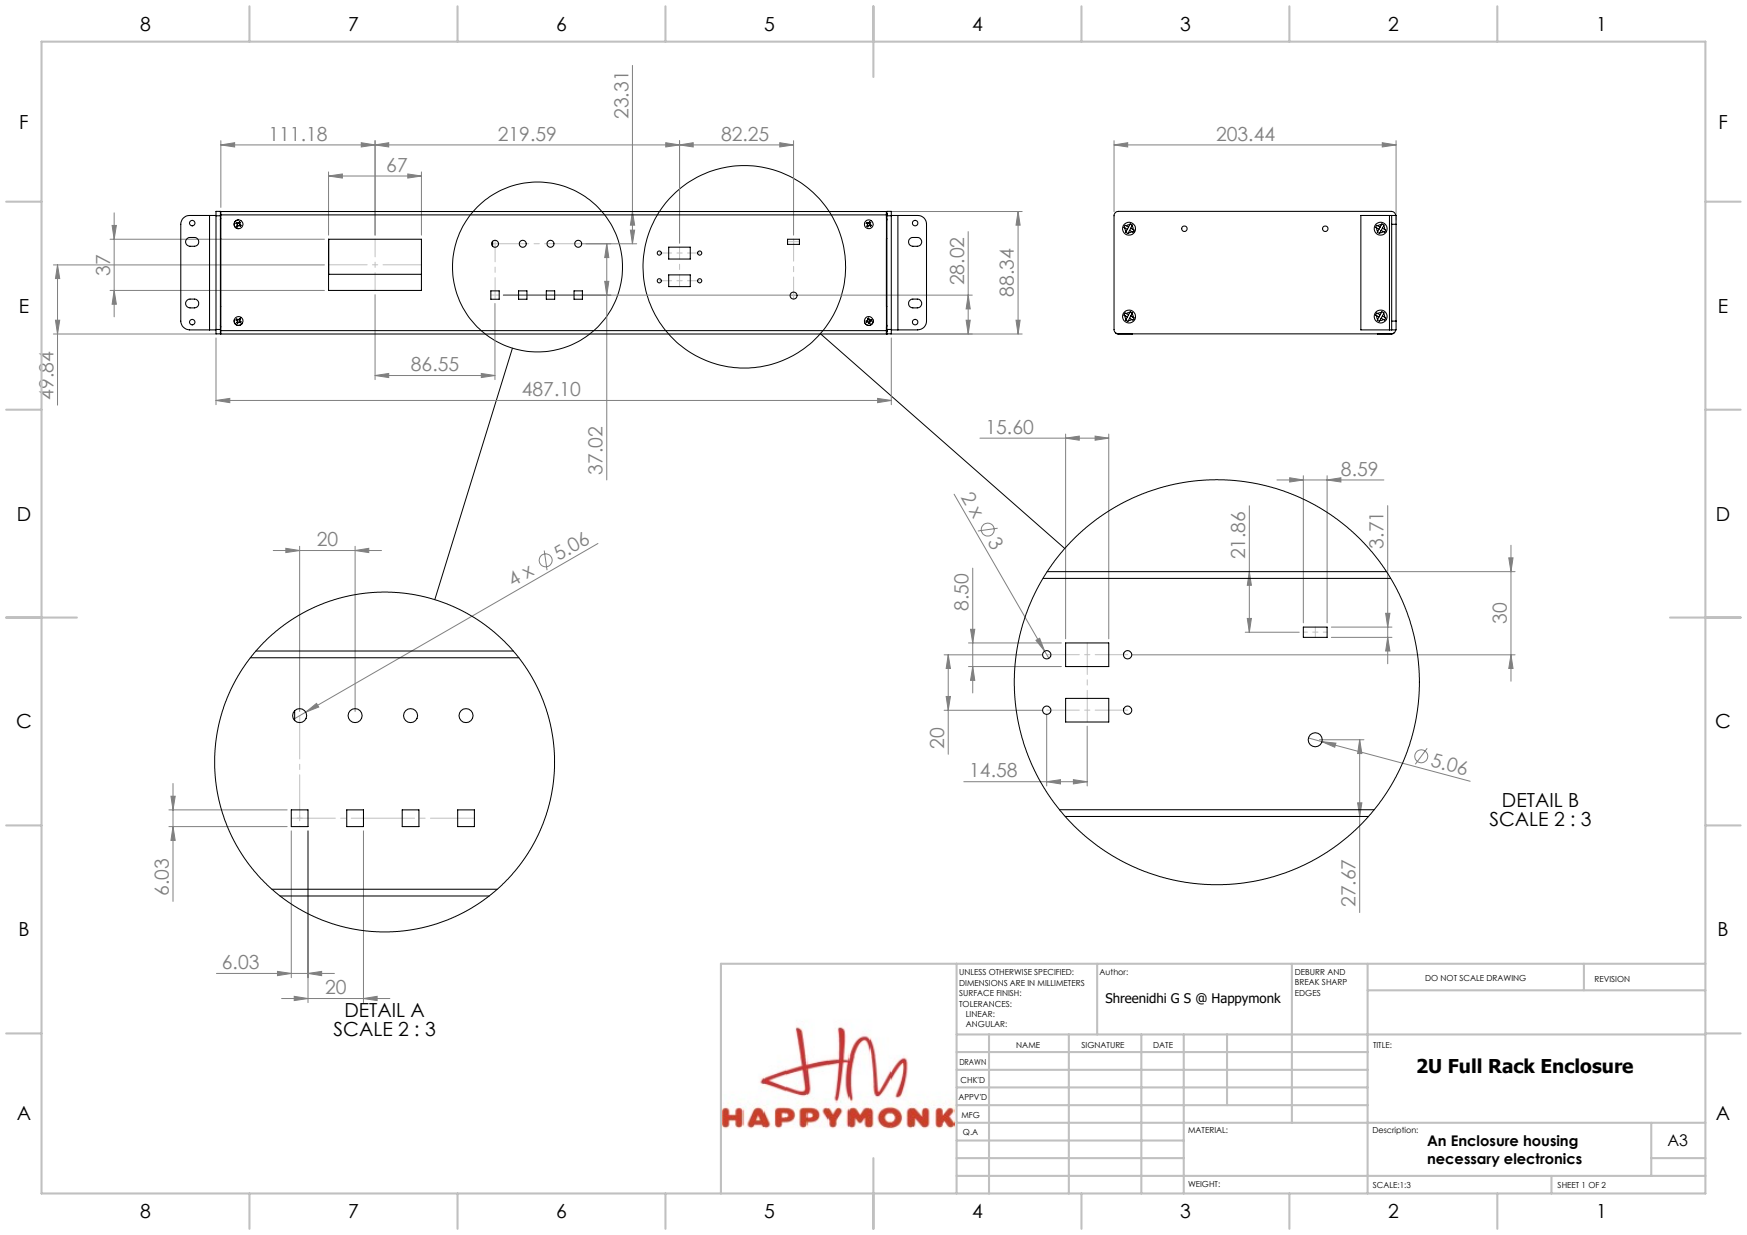
[picture p93: page 1]
DETAIL A SCALE 2 : 3; DETAIL B SCALE 2 : 3; Author:; DEBURR AND; BREAK SHARP; DO NOT SCALE DRAWING; REVISION; SCALE:1:3; SHEET 1 OF 2; Shreenidhi G S @ Happymonk

UNLESS OTHERWISE SPECIFIED:
DIMENSIONS ARE IN MILLIMETERS
SURFACE FINISH:
TOLERANCES:
LINEAR:
ANGULAR:

NAME | SIGNATURE | DATE | | | | TITLE: 2U Full Rack Enclosure

DRAWN
CHK'D
APPV'D
MFG
Q.A | | | | MATERIAL: | Description: An Enclosure housing necessary electronics | A3

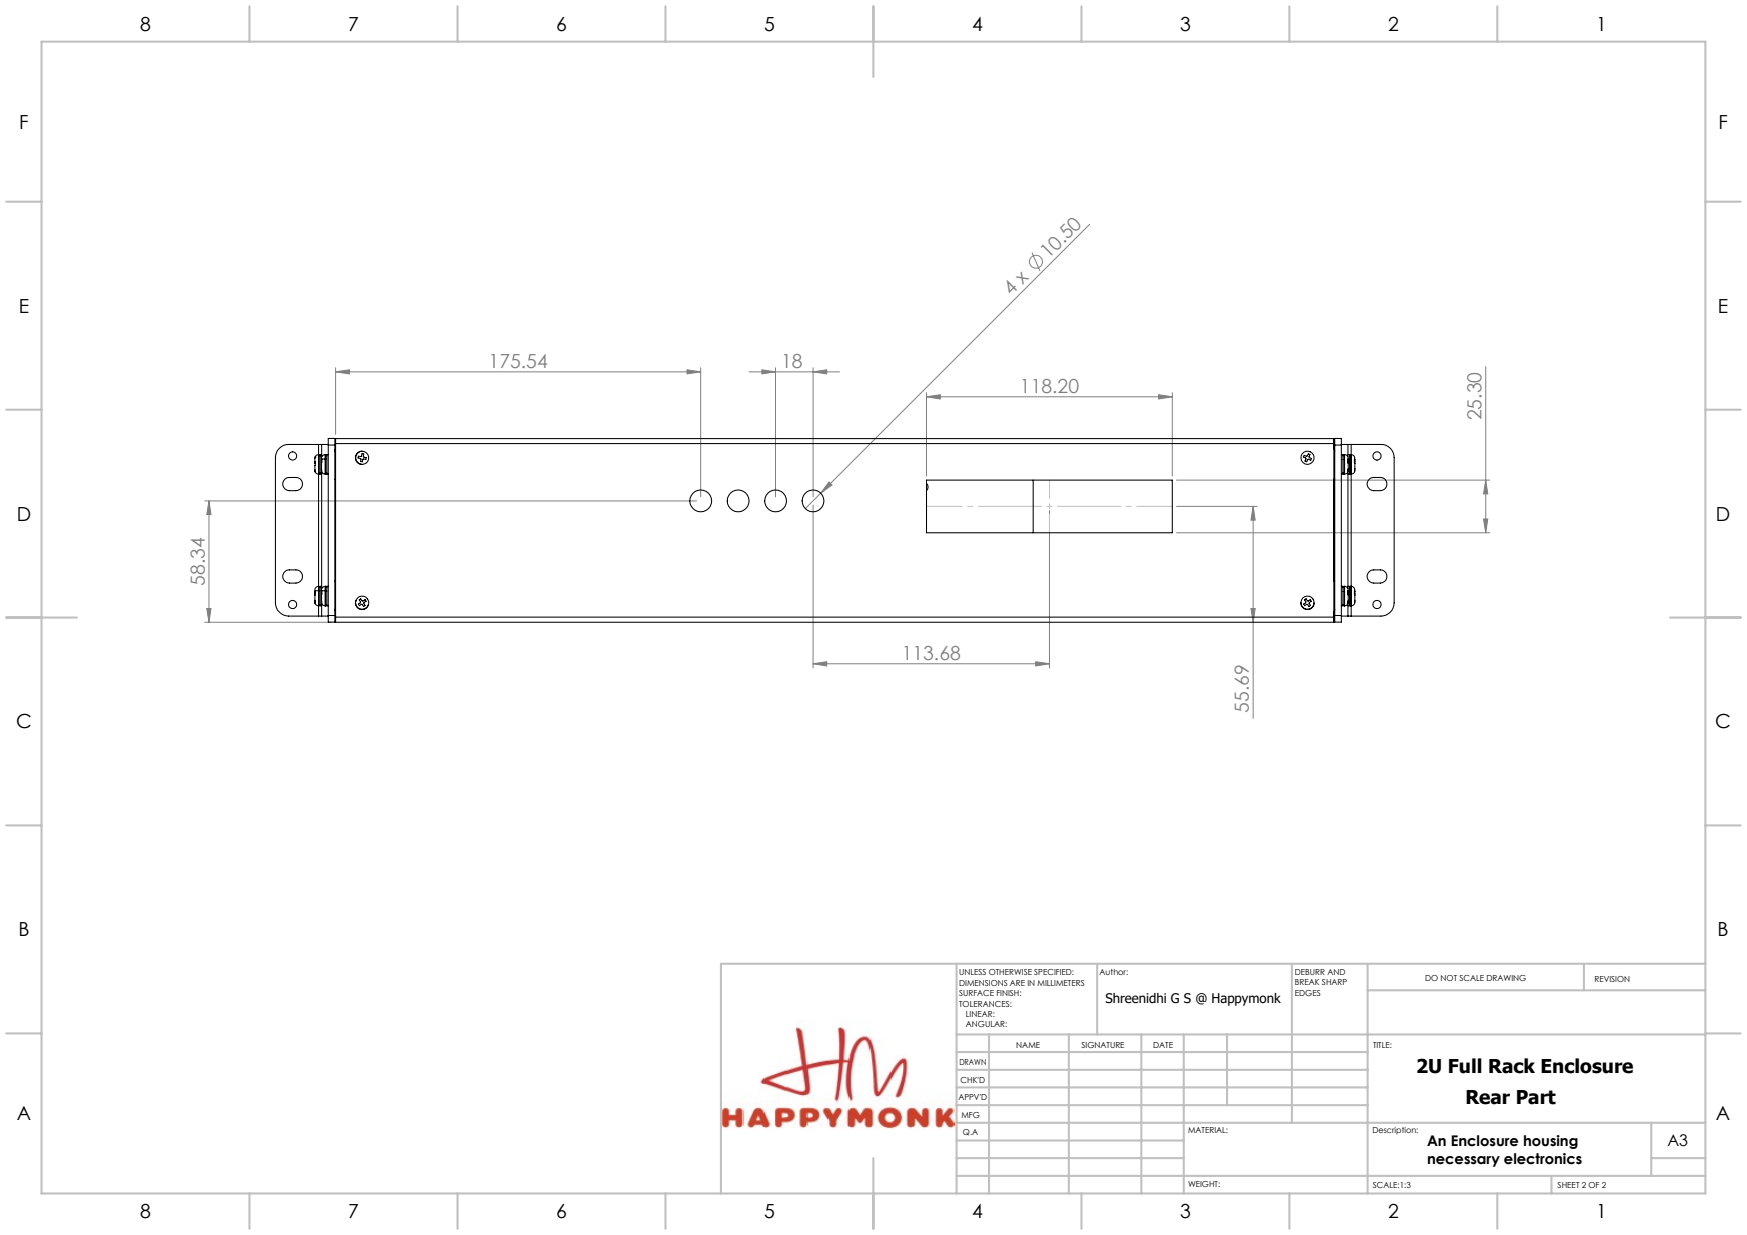
[picture p94: page 2]
Author:; DEBURR AND; BREAK SHARP; DO NOT SCALE DRAWING; REVISION; SCALE:1:3; SHEET 2 OF 2; Shreenidhi G S @ Happymonk

UNLESS OTHERWISE SPECIFIED:
DIMENSIONS ARE IN MILLIMETERS
SURFACE FINISH:
TOLERANCES:
LINEAR:
ANGULAR:

NAME | SIGNATURE | DATE | | | | TITLE: 2U Full Rack Enclosure Rear Part

DRAWN
CHK'D
APPV'D
MFG
Q.A | | | | MATERIAL: | Description: An Enclosure housing necessary electronics | A3
