happymonk-ai/enclosures/Project/Battery Pack and Draft files/Half rack 2U Enclosure Project.PDF

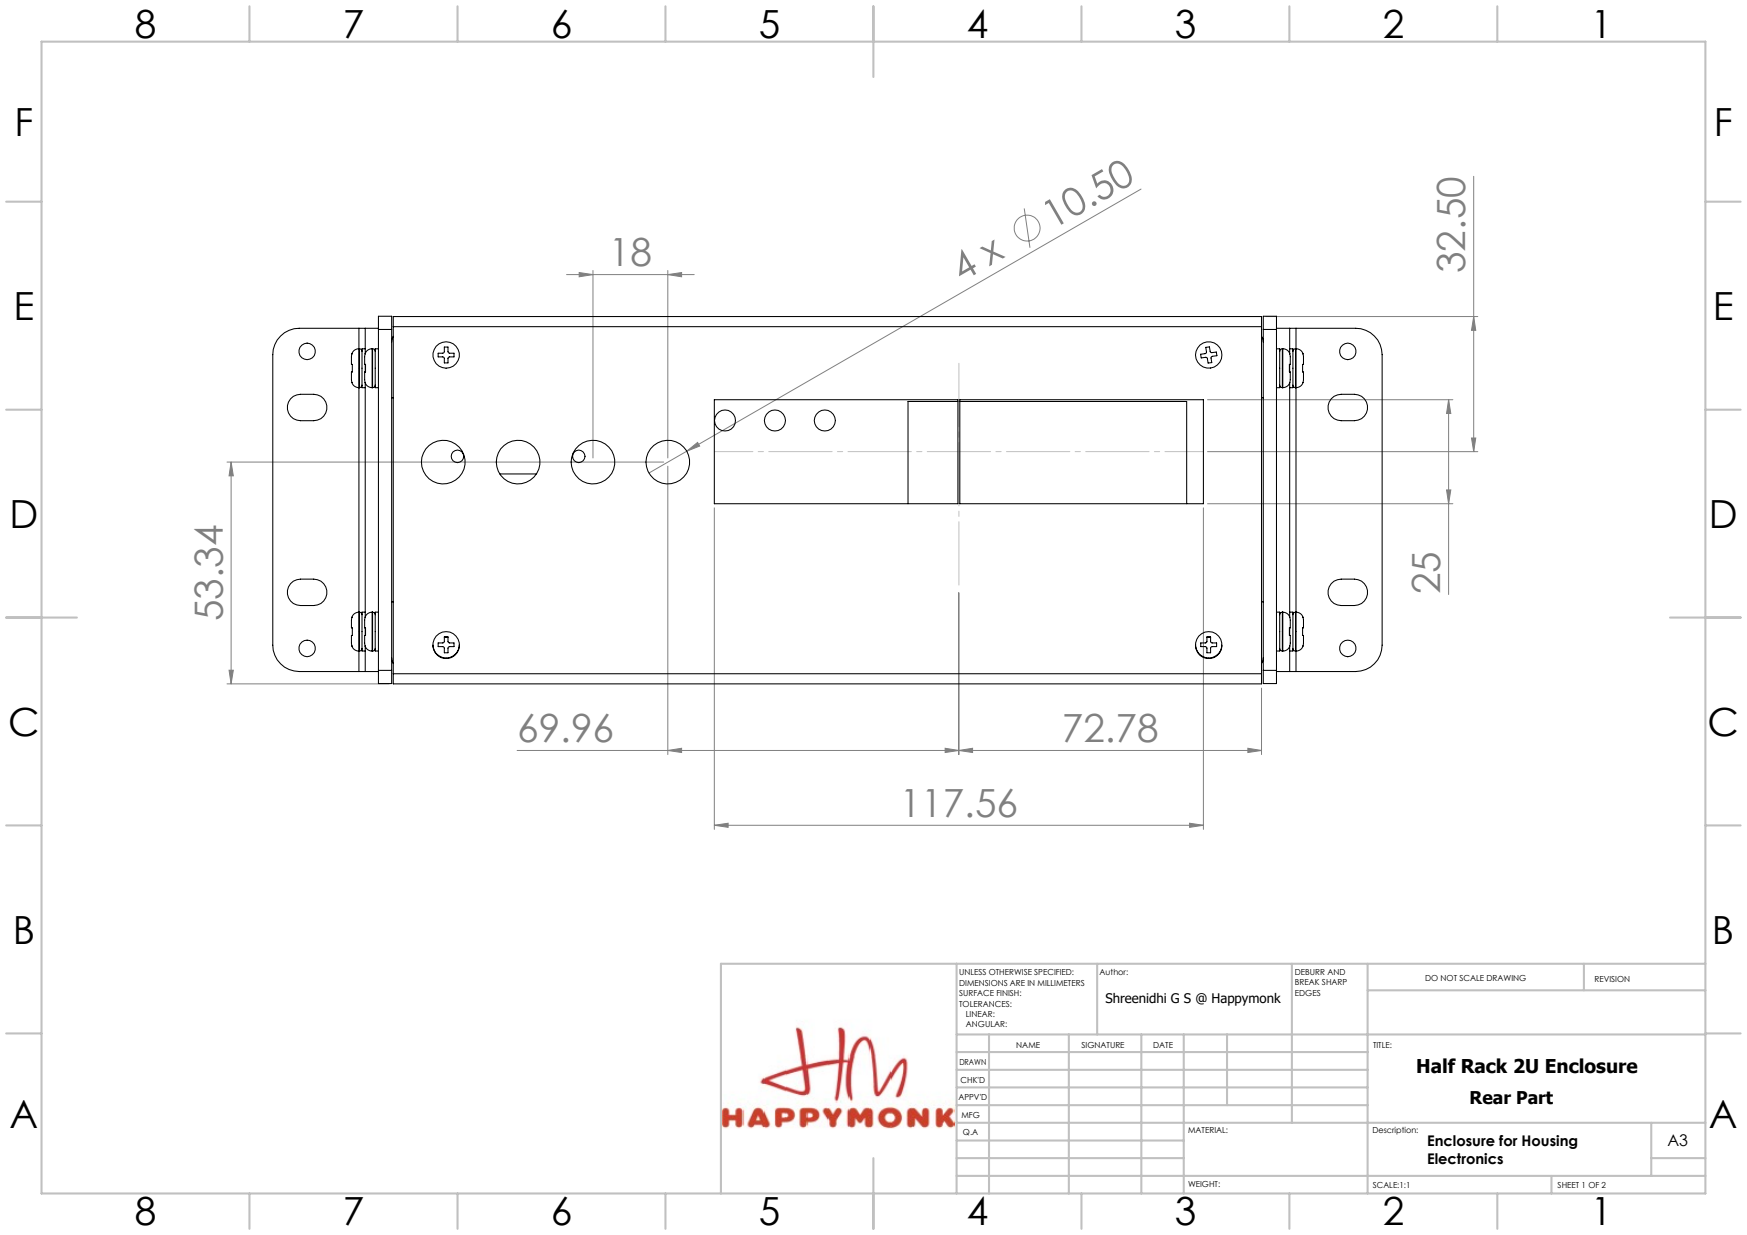
[picture p95: page 1]
Author:; DEBURR AND; BREAK SHARP; DO NOT SCALE DRAWING; REVISION; SCALE:1:1; SHEET 1 OF 2; Shreenidhi G S @ Happymonk

UNLESS OTHERWISE SPECIFIED:
DIMENSIONS ARE IN MILLIMETERS
SURFACE FINISH:
TOLERANCES:
LINEAR:
ANGULAR:

NAME | SIGNATURE | DATE | | | | TITLE: Half Rack 2U Enclosure Rear Part

DRAWN
CHK'D
APPV'D
MFG
Q.A | | | | MATERIAL: | Description: Enclosure for Housing Electronics | A3

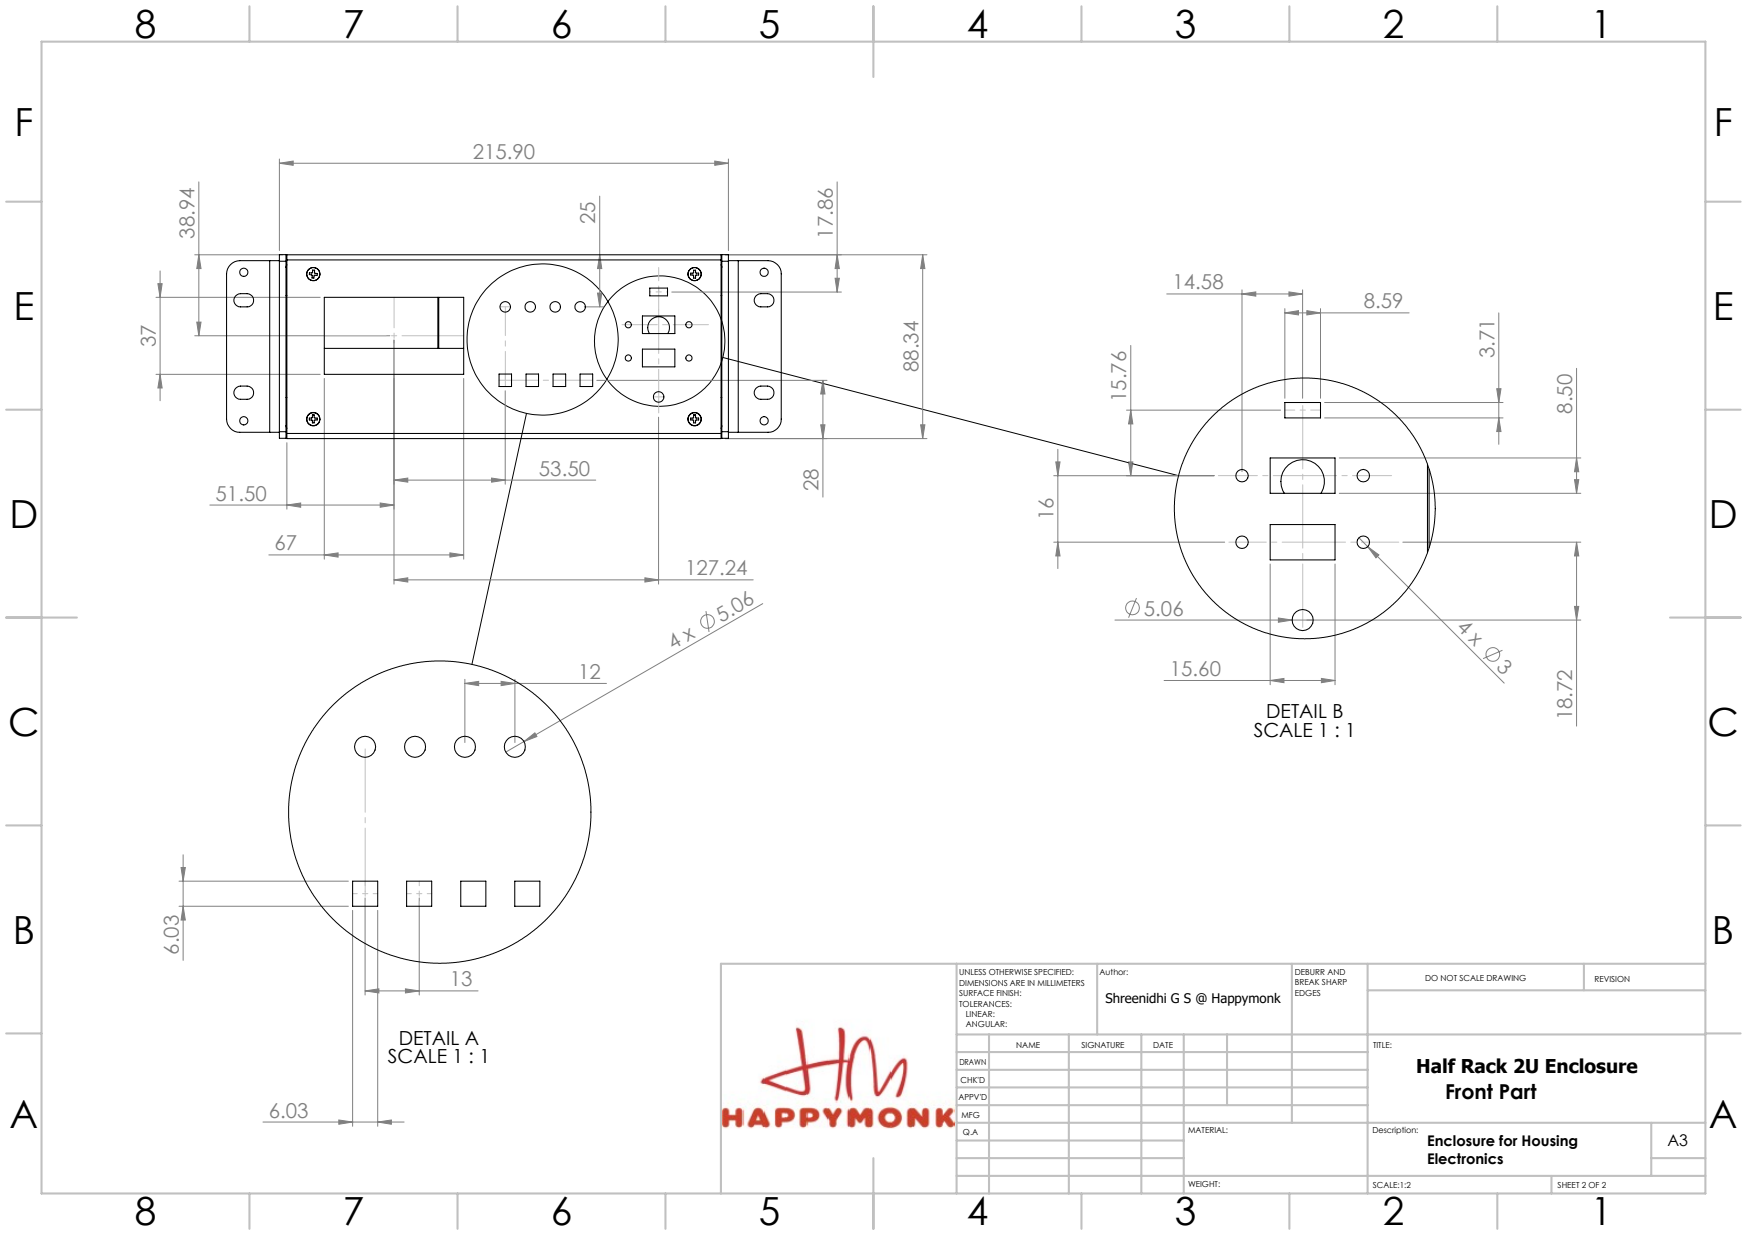
[picture p96: page 2]
DETAIL A SCALE 1 : 1; DETAIL B SCALE 1 : 1; Author:; DEBURR AND; BREAK SHARP; DO NOT SCALE DRAWING; REVISION; SCALE:1:2; SHEET 2 OF 2; Shreenidhi G S @ Happymonk

UNLESS OTHERWISE SPECIFIED:
DIMENSIONS ARE IN MILLIMETERS
SURFACE FINISH:
TOLERANCES:
LINEAR:
ANGULAR:

NAME | SIGNATURE | DATE | | | | TITLE: Half Rack 2U Enclosure Front Part

DRAWN
CHK'D
APPV'D
MFG
Q.A | | | | MATERIAL: | Description: Enclosure for Housing Electronics | A3
