happymonk-ai/enclosures/Project/Battery Pack and Draft files/Battery pack 1U Full Rack Enclosure/Battery Pack 1U enclosure.PDF

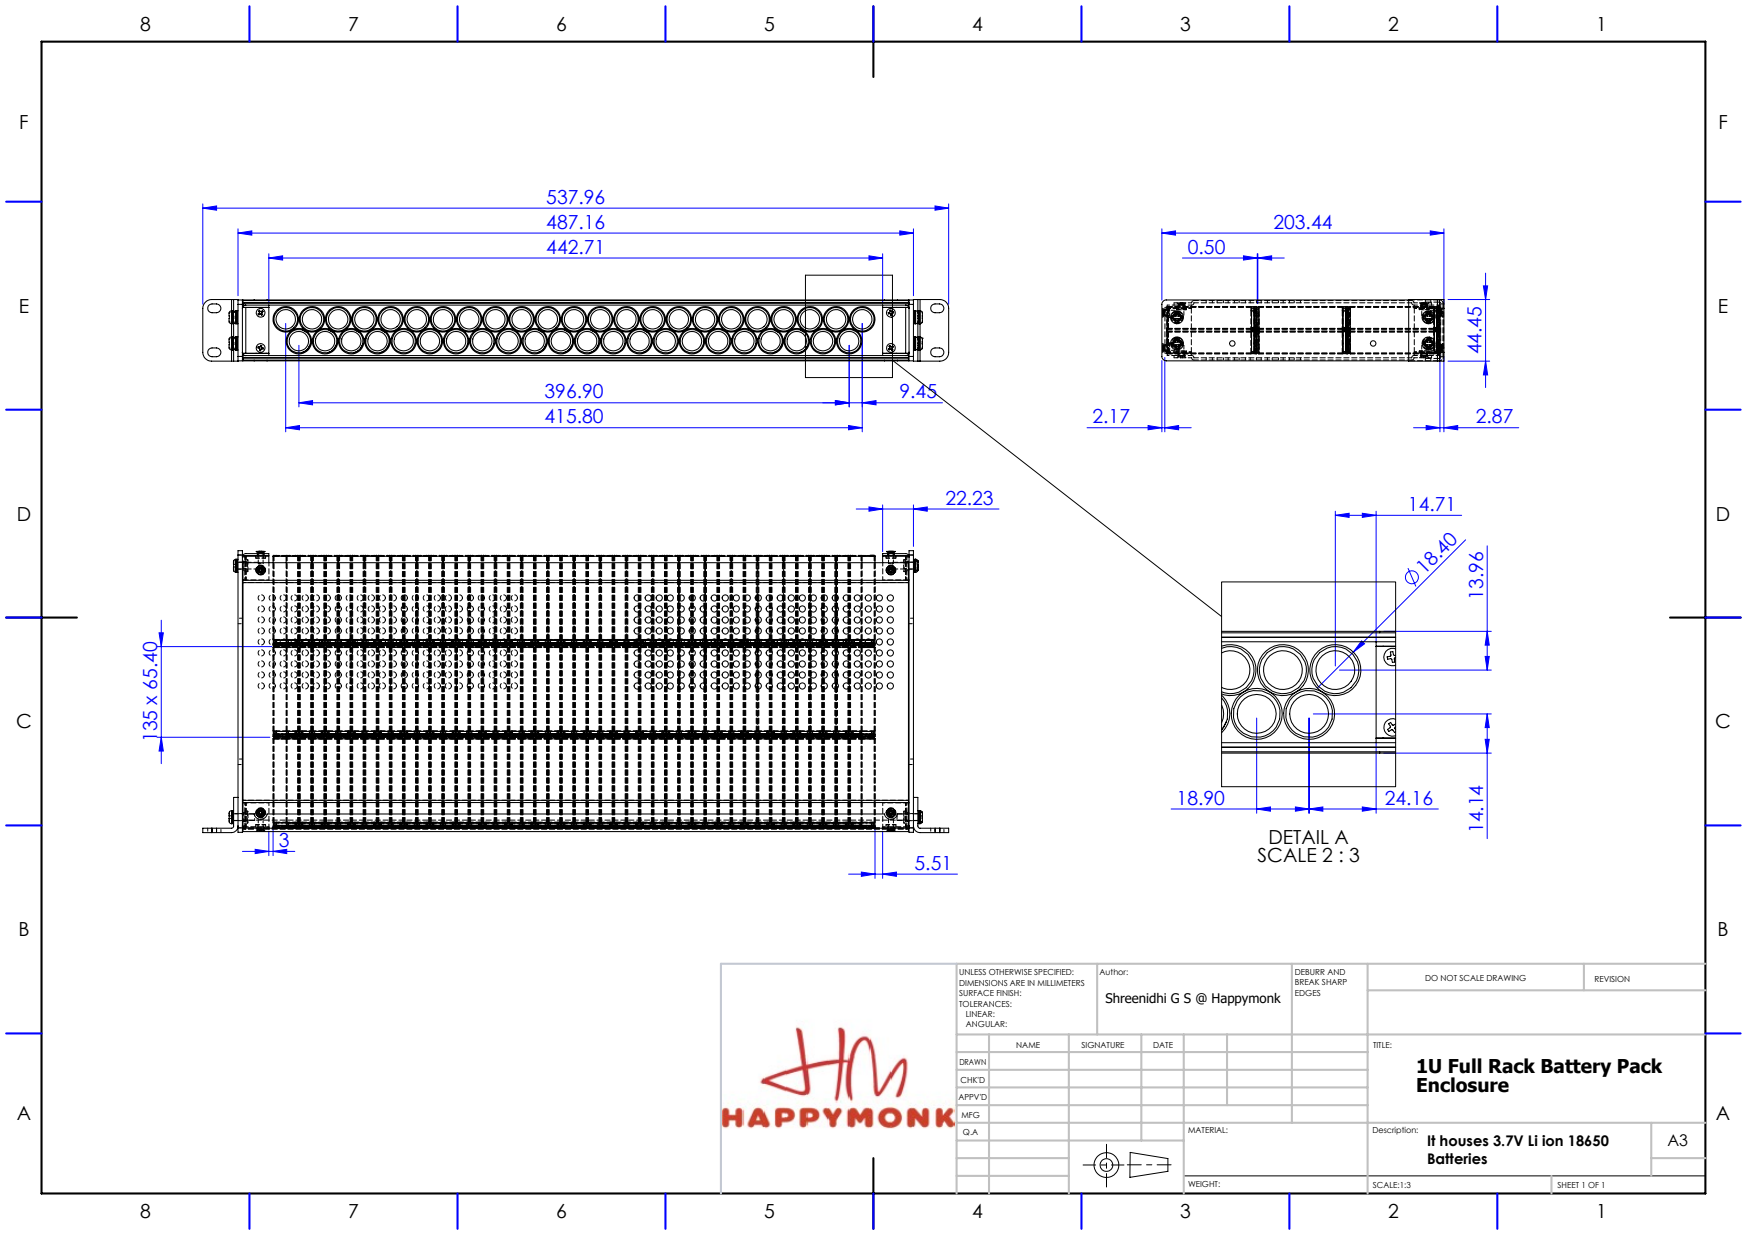
[picture p97: page 1]
DETAIL A SCALE 2 : 3; Author:; DEBURR AND; BREAK SHARP; DO NOT SCALE DRAWING; REVISION; SCALE:1:3; SHEET 1 OF 1; Shreenidhi G S @ Happymonk

UNLESS OTHERWISE SPECIFIED:
DIMENSIONS ARE IN MILLIMETERS
SURFACE FINISH:
TOLERANCES:
LINEAR:
ANGULAR:

NAME | SIGNATURE | DATE | | | TITLE: 1U Full Rack Battery Pack Enclosure

DRAWN
CHK'D
APPV'D
MFG
Q.A | | | | MATERIAL: WEIGHT: | A3

Description:
It houses 3.7V Li ion 18650
Batteries
