happymonk-ai/enclosures/Project/Battery Pack and Draft files/Battery pack 2U Full Rack Enclosure/Battery Pack Enclosure.PDF

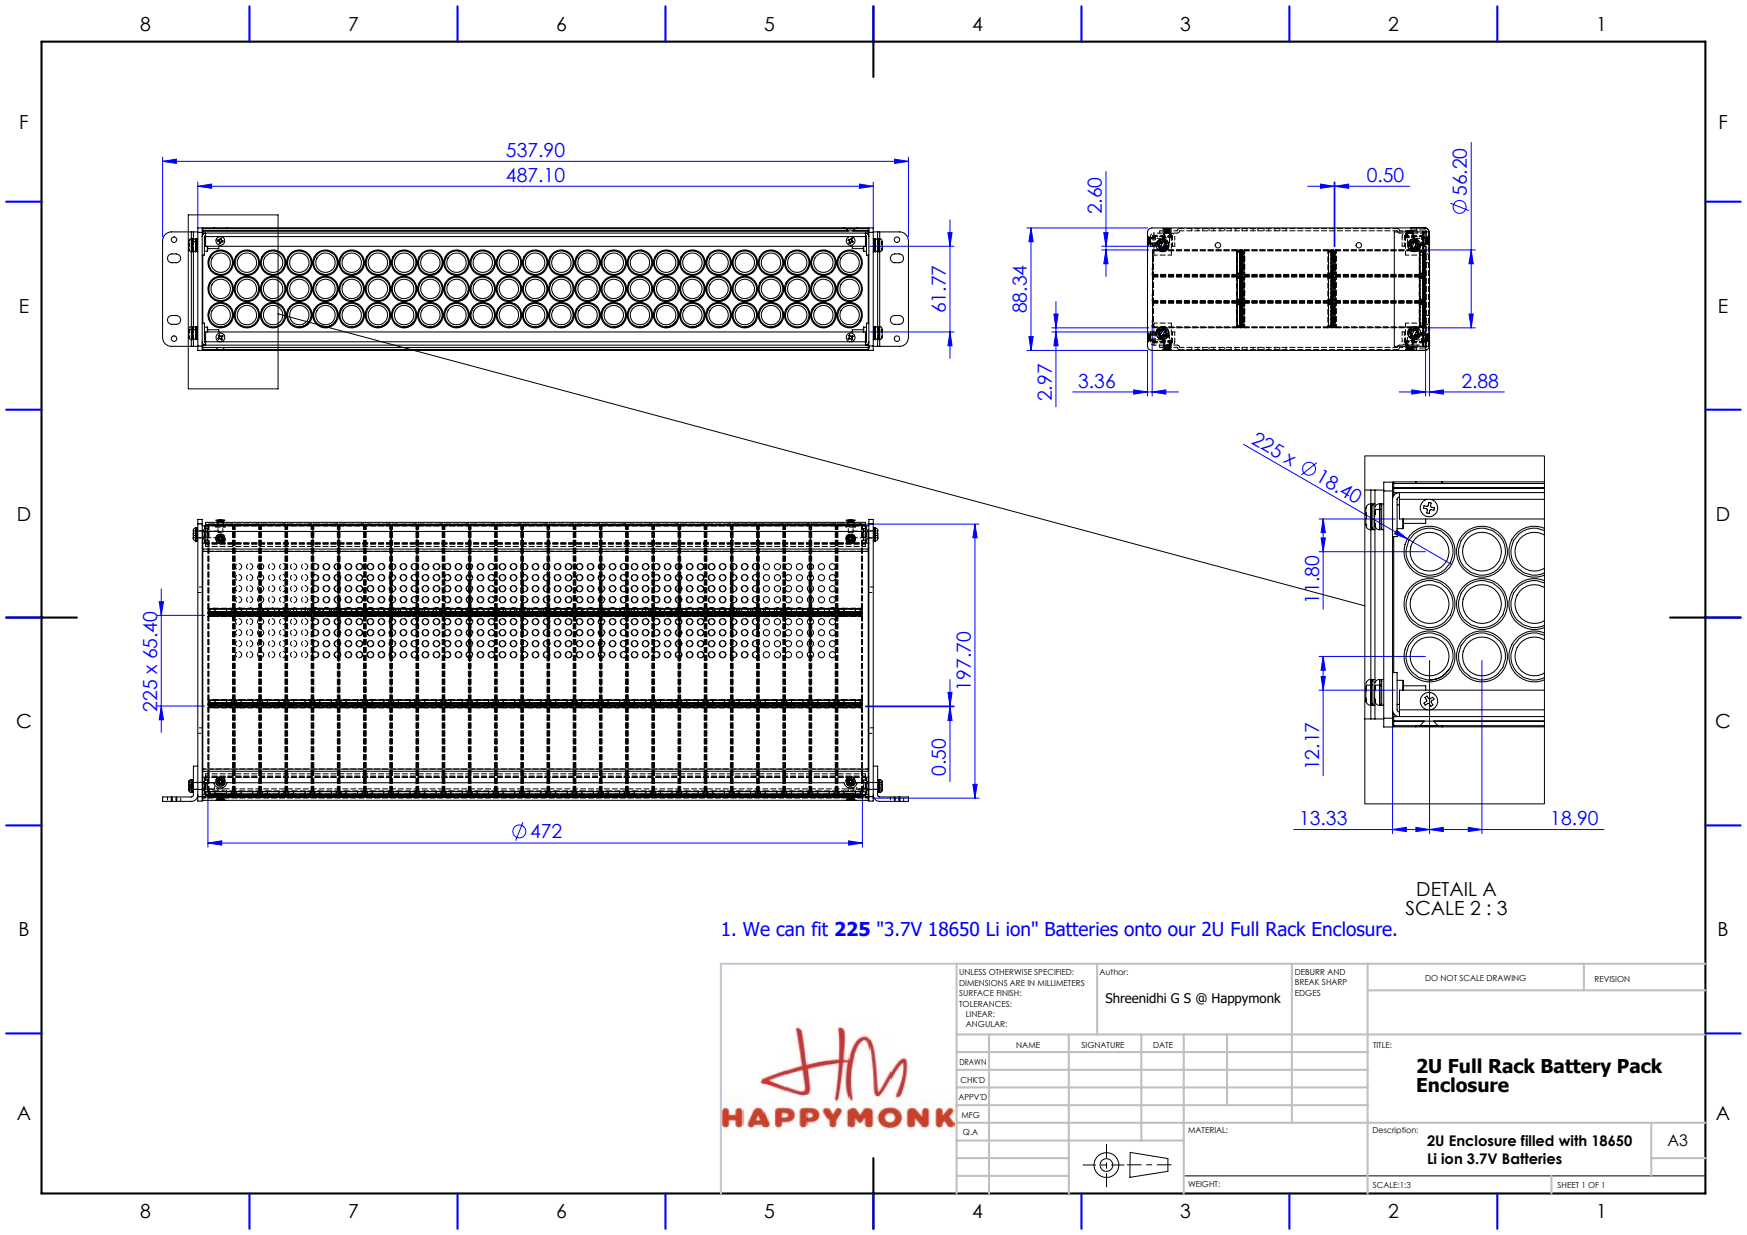
[picture p98: page 1]
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

1. We can fit 225 "3.7V 18650 Li ion" Batteries onto our 2U Full Rack Enclosure.

UNLESS OTHERWISE SPECIFIED:
DIMENSIONS ARE IN MILLIMETERS
SURFACE FINISH:
TOLERANCES:
LINEAR:
ANGULAR:

NAME | SIGNATURE | DATE | | | TITLE: 2U Full Rack Battery Pack Enclosure

DRAWN
CHK'D
APPV'D
MFG
Q.A | | | | MATERIAL: WEIGHT: | A3

Description:
2U Enclosure filled with 18650
Li ion 3.7V Batteries
