happymonk-ai/enclosures/(commit log)

2021-09-28 Enclosure files
    [Adhesive.SLDPRT, Antenna assy.SLDASM, Antenna base.SLDPRT, Antenna top.SLDPRT, COM53874-1.sldprt, COM53874-1_1.sldasm, COM53875-2.sldprt, COM53877-1.sldprt]
2021-09-29 full rack enclosure and other files
    [Adhesive.SLDPRT, Antenna assy.SLDASM, Antenna base.SLDPRT, Antenna top.SLDPRT, COM53874-1.sldprt, COM53874-1_1.sldasm, COM53874-2.sldprt, COM53874-2_1.sldasm]
2021-10-08 Draft and Battery Pack Enclosure files
    [18350 Низкий анод.SLDPRT, 18350 Низкий анод.STEP, 18500 Низкий анод.SLDPRT, 18500 Низкий анод.STEP, 18650 Lithium ion Battery.SLDPRT, 18650 Íèçêèé àíîä.sldprt, 18650 Íèçêèé àíîä_2.sldprt, 18650 Низкий анод.STEP]
2021-10-13 Battery pack 1U and 2U updated
    [Battery Pack 1U enclosure.SLDASM, Battery Pack 1U enclosure.SLDDRW, Battery Pack Enclosure - 2.SLDASM, Battery Pack Enclosure - 3.SLDASM, Battery Pack Enclosure.SLDASM, Battery Pack Enclosure.SLDDRW]
2021-10-27 New Main Module
    [2U Full rack Enclosure.x_t, 61304021821 (rev1).SLDASM, 61304021821.sldprt, 6130xx21821_PIN.sldprt, 614104150121.sldprt, 614104150121_2.sldprt, 614104150121_Download_STP_614104150121_rev1.SLDASM, 614104150121_Pin.sldprt]
2021-11-02 Prototype Enclosure Files
    [032-1441-000_1.sldprt, 032-1441-000_1_2.sldprt, 0402_H040.sldprt, 0402_H040_2.sldprt, 0402_H060.sldprt, 0402_H060_2.sldprt, 0402_H070.sldprt, 0402_H070_2.sldprt]
2021-11-03 prototype enclosure step file
2021-12-02 New 2U and 3U Enclosure Step Files
2021-12-03 Step files of enclosures with heat sinks
2021-12-17 Revision enclosure 0 new screen 2.8inch TFT LCD Disply added
2021-12-17 New Enclosure Step files
